ExcessiveOverkill/drive-hardware-dev/KiCad/HV servo drive v1/HV servo drive v1r2.step

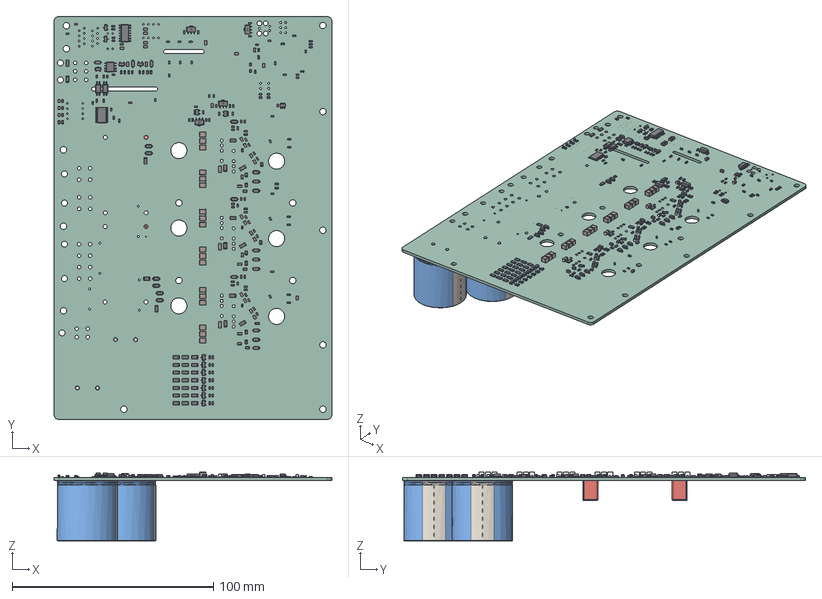
[picture p1: CAD file, 2025-09-05]
KiCad/HV servo drive v1/HV servo drive v1r2.step
138.2 x 200.4 x 34.2 mm
R_1206_3216Metric x 33
D_SOD_123 x 21
R_0603_1608Metric x 56
L_0603_1608Metric x 13
C_0603_1608Metric x 73
C_1210_3225Metric x 18
R_0805_2012Metric x 12
C_0805_2012Metric x 32
SOT_23 x 12
Fuse_1206_3216Metric x 2
C_1206_3216Metric x 3
LED_0603_1608Metric x 4
CQ assembly x 4
SOP_4_44x26mm_P127mm x 2
SOT_23_6
SOIC_14_39x87mm_P127mm
SOT_23_5 x 2
TSSOP_24_44x78mm_P065mm
SOIC_8_39x49mm_P127mm
C_Rect_L75mm_W65mm_P500mm x 2
CP_Radial_D300mm_P1000mm_SnapIn x 2
HV servo drive v1_PCB
