ExcessiveOverkill/drive-hardware-dev/manufacturing/case v3 bottom.stp

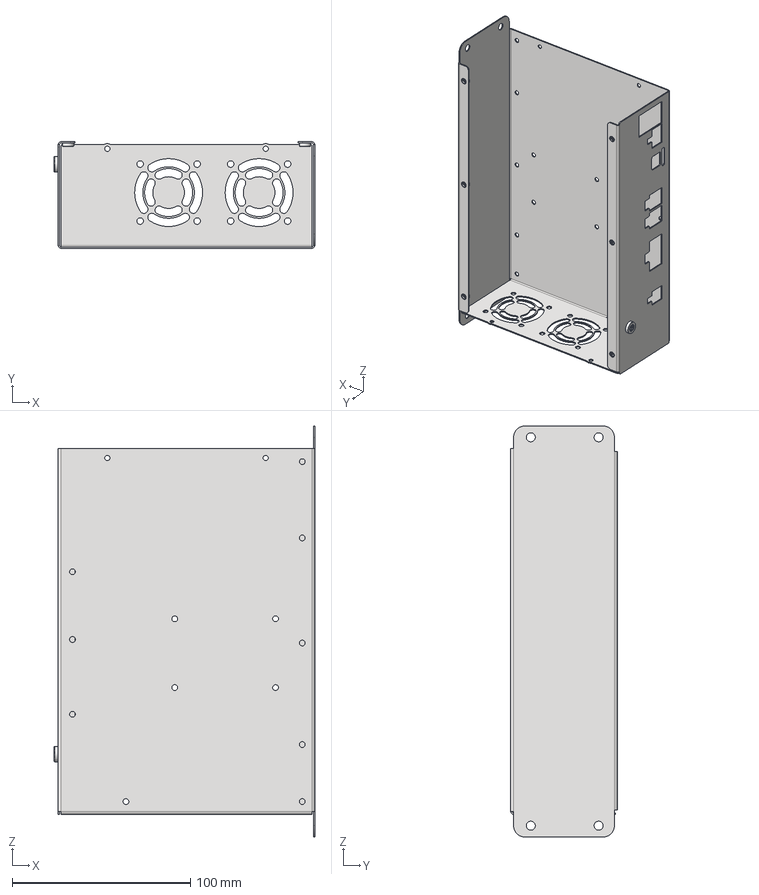
[picture p2: CAD file, 2025-09-05]
manufacturing/case v3 bottom.stp
146.3 x 59.8 x 230.7 mm
case v3_1
95185A110 x 6
95185A340
