ExcessiveOverkill/drive-hardware-dev/KiCad/HV servo drive v1/HV servo drive v1.step

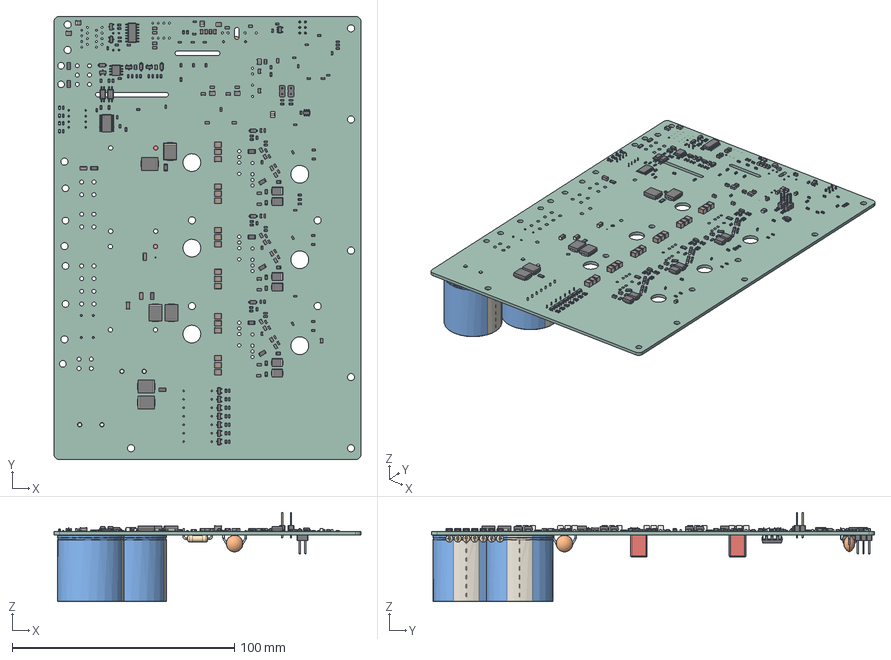
[picture p3: CAD file, 2025-09-05]
KiCad/HV servo drive v1/HV servo drive v1.step
138.2 x 199.5 x 40.2 mm
D_SMB x 6
R_0603_1608Metric x 59
C_0603_1608Metric x 60
C_1210_3225Metric x 18
PinHeader_1x02_P254mm_Vertical x 2
R_0805_2012Metric x 9
D_SOD_123 x 6
C_0805_2012Metric x 42
R_1206_3216Metric x 10
SOT_23 x 12
Fuse_1206_3216Metric x 2
C_1206_3216Metric x 4
L_1008_2520Metric x 8
LED_0603_1608Metric x 4
D_SMC x 6
L_0603_1608Metric x 9
SOP_4_44x26mm_P127mm x 2
SOT_23_5
SOT_23_6
SOIC_14_39x87mm_P127mm
TSSOP_24_44x78mm_P065mm
SOIC_8_39x49mm_P127mm
C_Disc_D75mm_W50mm_P1000mm x 3
R_Axial_DIN0309_L90mm_D32mm_P1270mm_Horizontal x 7
PinHeader_2x03_P254mm_Vertical
C_Rect_L75mm_W65mm_P500mm x 2
CP_Radial_D300mm_P1000mm_SnapIn x 2
DIP-8_W7.62mm
DIP-4_W7.62mm
HV servo drive v1_PCB
