ExcessiveOverkill/drive-hardware-dev/manufacturing/SanAce_9GA_40x20_RBD.stp

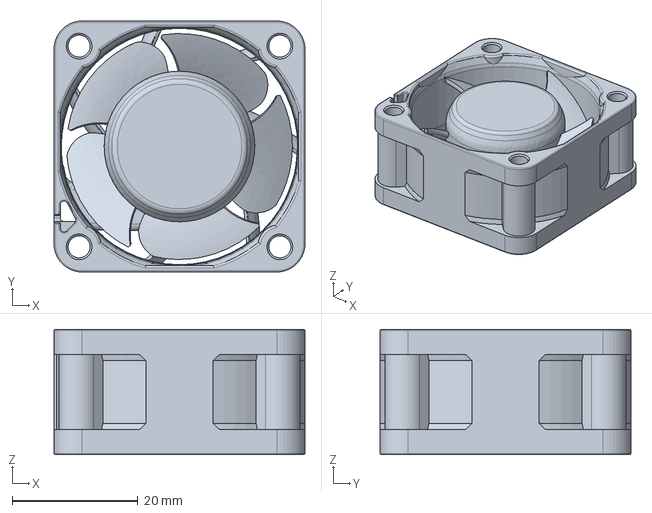
[picture p4: CAD file, 2025-09-05]
manufacturing/SanAce_9GA_40x20_RBD.stp
40.0 x 40.0 x 20.0 mm
