ExcessiveOverkill/drive-hardware-dev/manufacturing/front face.dxf

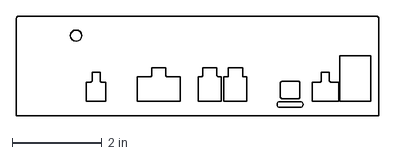
[picture p5: CAD file, 2025-09-05]
manufacturing/front face.dxf
8.08 x 2.23 in
