ExcessiveOverkill/drive-hardware-dev/manufacturing/fet leg bender.stl

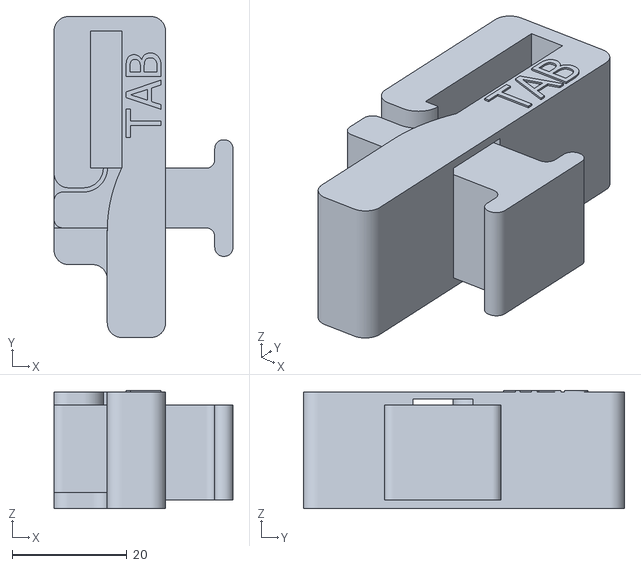
[picture p6: CAD file, 2025-09-05]
manufacturing/fet leg bender.stl
31.2 x 55.9 x 20.6
