ExcessiveOverkill/drive-hardware-dev/manufacturing/case v3 top.stp

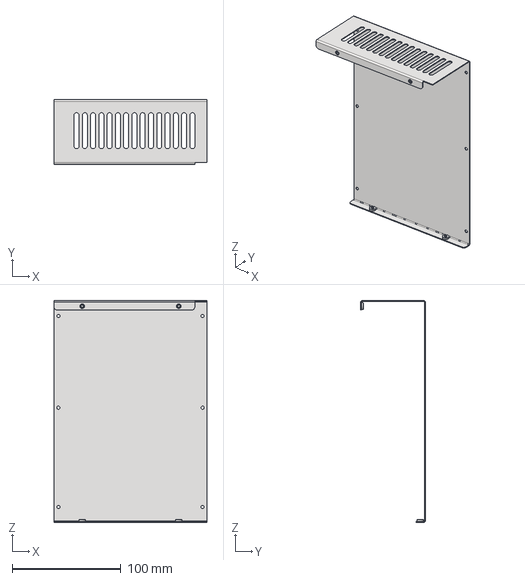
[picture p7: CAD file, 2025-09-05]
manufacturing/case v3 top.stp
140.8 x 59.8 x 204.5 mm
case v3 cover
95185A110 x 4
