ExcessiveOverkill/drive-hardware-dev/manufacturing/case v2 bottom.stp

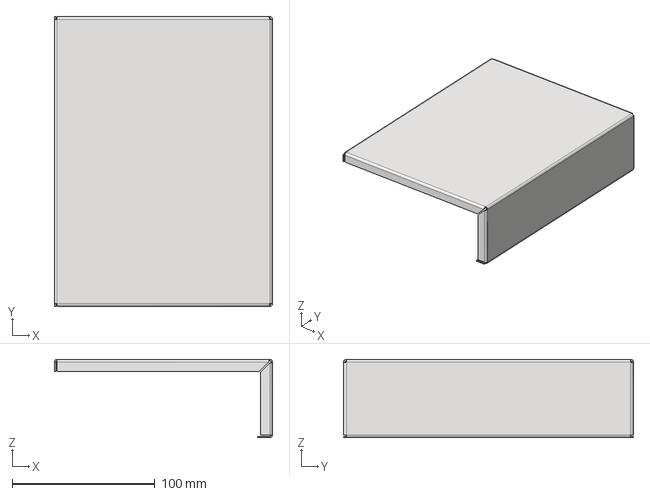
[picture p8: CAD file, 2025-09-05, an earlier design]
manufacturing/case v2 bottom.stp
152.9 x 203.2 x 54.9 mm
