ExcessiveOverkill/drive-hardware-dev/(list of files, cad)

Other CAD files:
manufacturing/case top.dwg
manufacturing/case bottom.dwg
manufacturing/OldVersions/case bottom.0001.dwg
manufacturing/OldVersions/case top.0002.dwg
manufacturing/OldVersions/case top.0001.dwg
manufacturing/HV servo drive v1 PCB.ipt
manufacturing/OldVersions/Solid1.0001.ipt
manufacturing/OldVersions/Solid2.0001.ipt
manufacturing/OldVersions/Solid2.0002.ipt
manufacturing/OldVersions/case v2.0002.ipt
manufacturing/OldVersions/case v3 cover.0001.ipt
manufacturing/OldVersions/case v3 cover.0002.ipt
manufacturing/OldVersions/case v3 cover.0003.ipt
manufacturing/OldVersions/case v3.0012.iam
manufacturing/OldVersions/case v3.0026.ipt
manufacturing/OldVersions/fet leg bender.0001.ipt
manufacturing/OldVersions/fet leg bender.0002.ipt
manufacturing/OldVersions/heatsink v2.0001.ipt
manufacturing/OldVersions/heatsink v2.0002.ipt
manufacturing/OldVersions/heatsink v2.0003.ipt
manufacturing/OldVersions/heatsink v2.0004.ipt
manufacturing/Solid1.ipt
manufacturing/Solid2.ipt
manufacturing/case v2.ipt
manufacturing/case v3 cover.ipt
manufacturing/case v3.iam
manufacturing/case v3.ipt
manufacturing/fet leg bender.ipt
manufacturing/heatsink v2.ipt
manufacturing/simple step/95185A110_Zinc-Plated Steel Press-Fit Nut for Sheet Metal/95185A110_Zinc-Plated Steel Press-Fit Nut for Sheet Metal.ipt
manufacturing/simple step/95185A340_Zinc-Plated Steel Press-Fit Nut for Sheet Metal/95185A340_Zinc-Plated Steel Press-Fit Nut for Sheet Metal.ipt
manufacturing/simple step/CP_Radial_D30.0mm_P10.00mm_SnapIn.iam
manufacturing/simple step/CP_Radial_D300mm_P1000mm_SnapIn.ipt
manufacturing/simple step/C_0603_1608Metric.iam
manufacturing/simple step/C_0603_1608Metric.ipt
manufacturing/simple step/C_0805_2012Metric.iam
manufacturing/simple step/C_0805_2012Metric.ipt
manufacturing/simple step/C_1206_3216Metric.iam
manufacturing/simple step/C_1206_3216Metric.ipt
manufacturing/simple step/C_1210_3225Metric.iam
manufacturing/simple step/C_1210_3225Metric.ipt
manufacturing/simple step/C_Disc_D7.5mm_W5.0mm_P10.00mm.iam
manufacturing/simple step/C_Disc_D75mm_W50mm_P1000mm.ipt
manufacturing/simple step/C_Rect_L7.5mm_W6.5mm_P5.00mm.iam
manufacturing/simple step/C_Rect_L75mm_W65mm_P500mm.ipt
manufacturing/simple step/DIP-4_W7.62mm.iam
manufacturing/simple step/DIP-4_W7.62mm.ipt
manufacturing/simple step/DIP-8_W7.62mm.iam
manufacturing/simple step/DIP-8_W7.62mm.ipt
manufacturing/simple step/D_SMB.iam
manufacturing/simple step/D_SMB.ipt
manufacturing/simple step/D_SMC.iam
manufacturing/simple step/D_SMC.ipt
manufacturing/simple step/D_SOD-123.iam
manufacturing/simple step/D_SOD_123.ipt
manufacturing/simple step/Fuse_1206_3216Metric.iam
manufacturing/simple step/Fuse_1206_3216Metric.ipt
manufacturing/simple step/HV servo drive v1.iam
manufacturing/simple step/HV servo drive v1_PCB.ipt
manufacturing/simple step/HV servo drive v1r2/CP_Radial_D30.0mm_P10.00mm_SnapIn.iam
manufacturing/simple step/HV servo drive v1r2/CP_Radial_D300mm_P1000mm_SnapIn.ipt
manufacturing/simple step/HV servo drive v1r2/CQ assembly.ipt
manufacturing/simple step/HV servo drive v1r2/C_0603_1608Metric.iam
manufacturing/simple step/HV servo drive v1r2/C_0603_1608Metric.ipt
manufacturing/simple step/HV servo drive v1r2/C_0805_2012Metric.iam
manufacturing/simple step/HV servo drive v1r2/C_0805_2012Metric.ipt
manufacturing/simple step/HV servo drive v1r2/C_1206_3216Metric.iam
manufacturing/simple step/HV servo drive v1r2/C_1206_3216Metric.ipt
manufacturing/simple step/HV servo drive v1r2/C_1210_3225Metric.iam
manufacturing/simple step/HV servo drive v1r2/C_1210_3225Metric.ipt
manufacturing/simple step/HV servo drive v1r2/C_Rect_L7.5mm_W6.5mm_P5.00mm.iam
manufacturing/simple step/HV servo drive v1r2/C_Rect_L75mm_W65mm_P500mm.ipt
manufacturing/simple step/HV servo drive v1r2/D_SOD-123.iam
manufacturing/simple step/HV servo drive v1r2/D_SOD_123.ipt
manufacturing/simple step/HV servo drive v1r2/Fuse_1206_3216Metric.iam
manufacturing/simple step/HV servo drive v1r2/Fuse_1206_3216Metric.ipt
manufacturing/simple step/HV servo drive v1r2/HV servo drive v1_PCB.ipt
manufacturing/simple step/HV servo drive v1r2/HV servo drive v1r2.iam
manufacturing/simple step/HV servo drive v1r2/LED_0603_1608Metric.iam
manufacturing/simple step/HV servo drive v1r2/LED_0603_1608Metric.ipt
manufacturing/simple step/HV servo drive v1r2/L_0603_1608Metric.iam
manufacturing/simple step/HV servo drive v1r2/L_0603_1608Metric.ipt
manufacturing/simple step/HV servo drive v1r2/OldVersions/HV servo drive v1_PCB.0001.ipt
manufacturing/simple step/HV servo drive v1r2/OldVersions/HV servo drive v1_PCB.0002.ipt
manufacturing/simple step/HV servo drive v1r2/OldVersions/HV servo drive v1_PCB.0003.ipt
manufacturing/simple step/HV servo drive v1r2/OldVersions/HV servo drive v1r2.0001.iam
manufacturing/simple step/HV servo drive v1r2/R_0603_1608Metric.iam
manufacturing/simple step/HV servo drive v1r2/R_0603_1608Metric.ipt
manufacturing/simple step/HV servo drive v1r2/R_0805_2012Metric.iam
manufacturing/simple step/HV servo drive v1r2/R_0805_2012Metric.ipt
manufacturing/simple step/HV servo drive v1r2/R_1206_3216Metric.iam
manufacturing/simple step/HV servo drive v1r2/R_1206_3216Metric.ipt
manufacturing/simple step/HV servo drive v1r2/SOIC-14_3.9x8.7mm_P1.27mm.iam
manufacturing/simple step/HV servo drive v1r2/SOIC-8_3.9x4.9mm_P1.27mm.iam
manufacturing/simple step/HV servo drive v1r2/SOIC_14_39x87mm_P127mm.ipt
manufacturing/simple step/HV servo drive v1r2/SOIC_8_39x49mm_P127mm.ipt
manufacturing/simple step/HV servo drive v1r2/SOP-4_4.4x2.6mm_P1.27mm.iam
manufacturing/simple step/HV servo drive v1r2/SOP_4_44x26mm_P127mm.ipt
manufacturing/simple step/HV servo drive v1r2/SOT-23-5.iam
manufacturing/simple step/HV servo drive v1r2/SOT-23-6.iam
manufacturing/simple step/HV servo drive v1r2/SOT-23.iam
manufacturing/simple step/HV servo drive v1r2/SOT-89-3.iam
manufacturing/simple step/HV servo drive v1r2/SOT_23.ipt
manufacturing/simple step/HV servo drive v1r2/SOT_23_5.ipt
manufacturing/simple step/HV servo drive v1r2/SOT_23_6.ipt
manufacturing/simple step/HV servo drive v1r2/TSSOP-24_4.4x7.8mm_P0.65mm.iam
manufacturing/simple step/HV servo drive v1r2/TSSOP_24_44x78mm_P065mm.ipt
manufacturing/simple step/LED_0603_1608Metric.iam
manufacturing/simple step/LED_0603_1608Metric.ipt
manufacturing/simple step/L_0603_1608Metric.iam
manufacturing/simple step/L_0603_1608Metric.ipt
manufacturing/simple step/L_1008_2520Metric.iam
manufacturing/simple step/L_1008_2520Metric.ipt
manufacturing/simple step/OldVersions/HV servo drive v1_PCB.0001.ipt
manufacturing/simple step/PinHeader_1x02_P2.54mm_Vertical.iam
manufacturing/simple step/PinHeader_1x02_P254mm_Vertical.ipt
manufacturing/simple step/PinHeader_2x03_P2.54mm_Vertical.iam
manufacturing/simple step/PinHeader_2x03_P254mm_Vertical.ipt
manufacturing/simple step/R_0603_1608Metric.iam
manufacturing/simple step/R_0603_1608Metric.ipt
manufacturing/simple step/R_0805_2012Metric.iam
manufacturing/simple step/R_0805_2012Metric.ipt
manufacturing/simple step/R_1206_3216Metric.iam
manufacturing/simple step/R_1206_3216Metric.ipt
manufacturing/simple step/R_Axial_DIN0309_L9.0mm_D3.2mm_P12.70mm_Horizontal.iam
manufacturing/simple step/R_Axial_DIN0309_L90mm_D32mm_P1270mm_Horizontal.ipt
manufacturing/simple step/SOIC-14_3.9x8.7mm_P1.27mm.iam
manufacturing/simple step/SOIC-8_3.9x4.9mm_P1.27mm.iam
manufacturing/simple step/SOIC_14_39x87mm_P127mm.ipt
manufacturing/simple step/SOIC_8_39x49mm_P127mm.ipt
manufacturing/simple step/SOP-4_4.4x2.6mm_P1.27mm.iam
manufacturing/simple step/SOP_4_44x26mm_P127mm.ipt
manufacturing/simple step/SOT-23-5.iam
manufacturing/simple step/SOT-23-6.iam
manufacturing/simple step/SOT-23.iam
manufacturing/simple step/SOT_23.ipt
manufacturing/simple step/SOT_23_5.ipt
manufacturing/simple step/SOT_23_6.ipt
manufacturing/simple step/SanAce_9GA_40x20_RBD/SanAce_9GA_40x20_RBD.ipt
manufacturing/simple step/TSSOP-24_4.4x7.8mm_P0.65mm.iam
manufacturing/simple step/TSSOP_24_44x78mm_P065mm.ipt
