ExcessiveOverkill/drive-hardware-dev/(threads)

Thread 11 (2024-03-10):

ADC power limiting for safety

ExcessiveOverkill, 2024-03-10:
Limit power supplied to the ADCs from both sides. In the event of a power supply failure, the ADCs may overheat and cause damage to the isolation layer which is VERY bad.

This is not a critical issue as there is already separate isolation for the main communication.

Thread 12 (2024-03-10):

shorted trace in gate drive circuit

ExcessiveOverkill, 2024-03-10:
remove bridged trace

Closed 2025-09-05.

Thread 13 (2024-03-10):

HV HF filter caps

ExcessiveOverkill, 2024-03-10:
Add high frequency ceramic caps near each fet bridge for DC bus filtering and phase overshoot filtering.

Closed 2025-09-05.

Thread 16 (2024-03-10):

mosfet bridge tuning

ExcessiveOverkill, 2024-03-10:
optimize gate drive resistance and filter capacitors to get efficient switching without too much EMI

Closed 2025-09-05.

Thread 17 (2024-03-10):

isolation slots

ExcessiveOverkill, 2024-03-10:
add isolation/clearance slots where needed

Closed 2025-09-05.

Thread 3 (2024-03-10):

MCU STO pin

ExcessiveOverkill, 2024-03-10:
investigate why STO is not active by default. It should require input from the MCU to enable power outputs

Aaron-Levan, 2024-04-23:
How was the output from the MCU configured?
From the 6N137 datasheet, the opto will operate if the enable input is left floating.
It looks like a pulldown on the opto's enable input should keep STO active unless the MCU output is high.

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

ExcessiveOverkill, 2024-04-23:
ah that would do it. the MCU output was unconfigured so it was floating

Closed 2025-09-05.

Thread 4 (2024-03-10):

RJ45 connector wrong pinout

ExcessiveOverkill, 2024-03-10:
fix pinout for rj45 jack, one of the connector's pin order is reversed

Closed 2025-09-05.

Thread 5 (2024-03-10):

gate drive supply reverse polarity protection

ExcessiveOverkill, 2024-03-10:
fit the issue where the low side gate drive supply can be driven negative by the gate drivers if the dc-dc converter is not connected. this can result in not being able to switch off the fets.

Closed 2025-09-05.

Thread 6 (2024-03-10):

dc-dc converter wrong footprint

ExcessiveOverkill, 2024-03-10:
fix the footprint for the +15v gate drive isolated converter

Closed 2025-09-05.

Thread 7 (2024-03-10):

add another heatsink mounting hole

ExcessiveOverkill, 2024-03-10:
add another hole so the board doesn't flex as much

Thread 8 (2024-03-10):

clearance between heatsink and electrolysic bus caps

ExcessiveOverkill, 2024-03-10:
add space between heatsink and dc bus caps

Thread 21 (2025-09-05):

Fix output filter

ExcessiveOverkill, 2025-09-05:
Revise output filter to fix inductor overvoltage, resistor heating, and uneven filtering. See about switching to SMD caps on the output.

Thread 22 (2025-09-05):

rs422 EMI reduction

ExcessiveOverkill, 2025-09-05:
Add filtering to the communication ports to help reduce conducted EMI
