ExcessiveOverkill/drive-hardware-dev/KiCad/HV servo drive v1/HV servo drive v1.kicad_pcb

## KiCad design KiCad/HV servo drive v1/HV servo drive v1.kicad_pcb (2025-09-05)

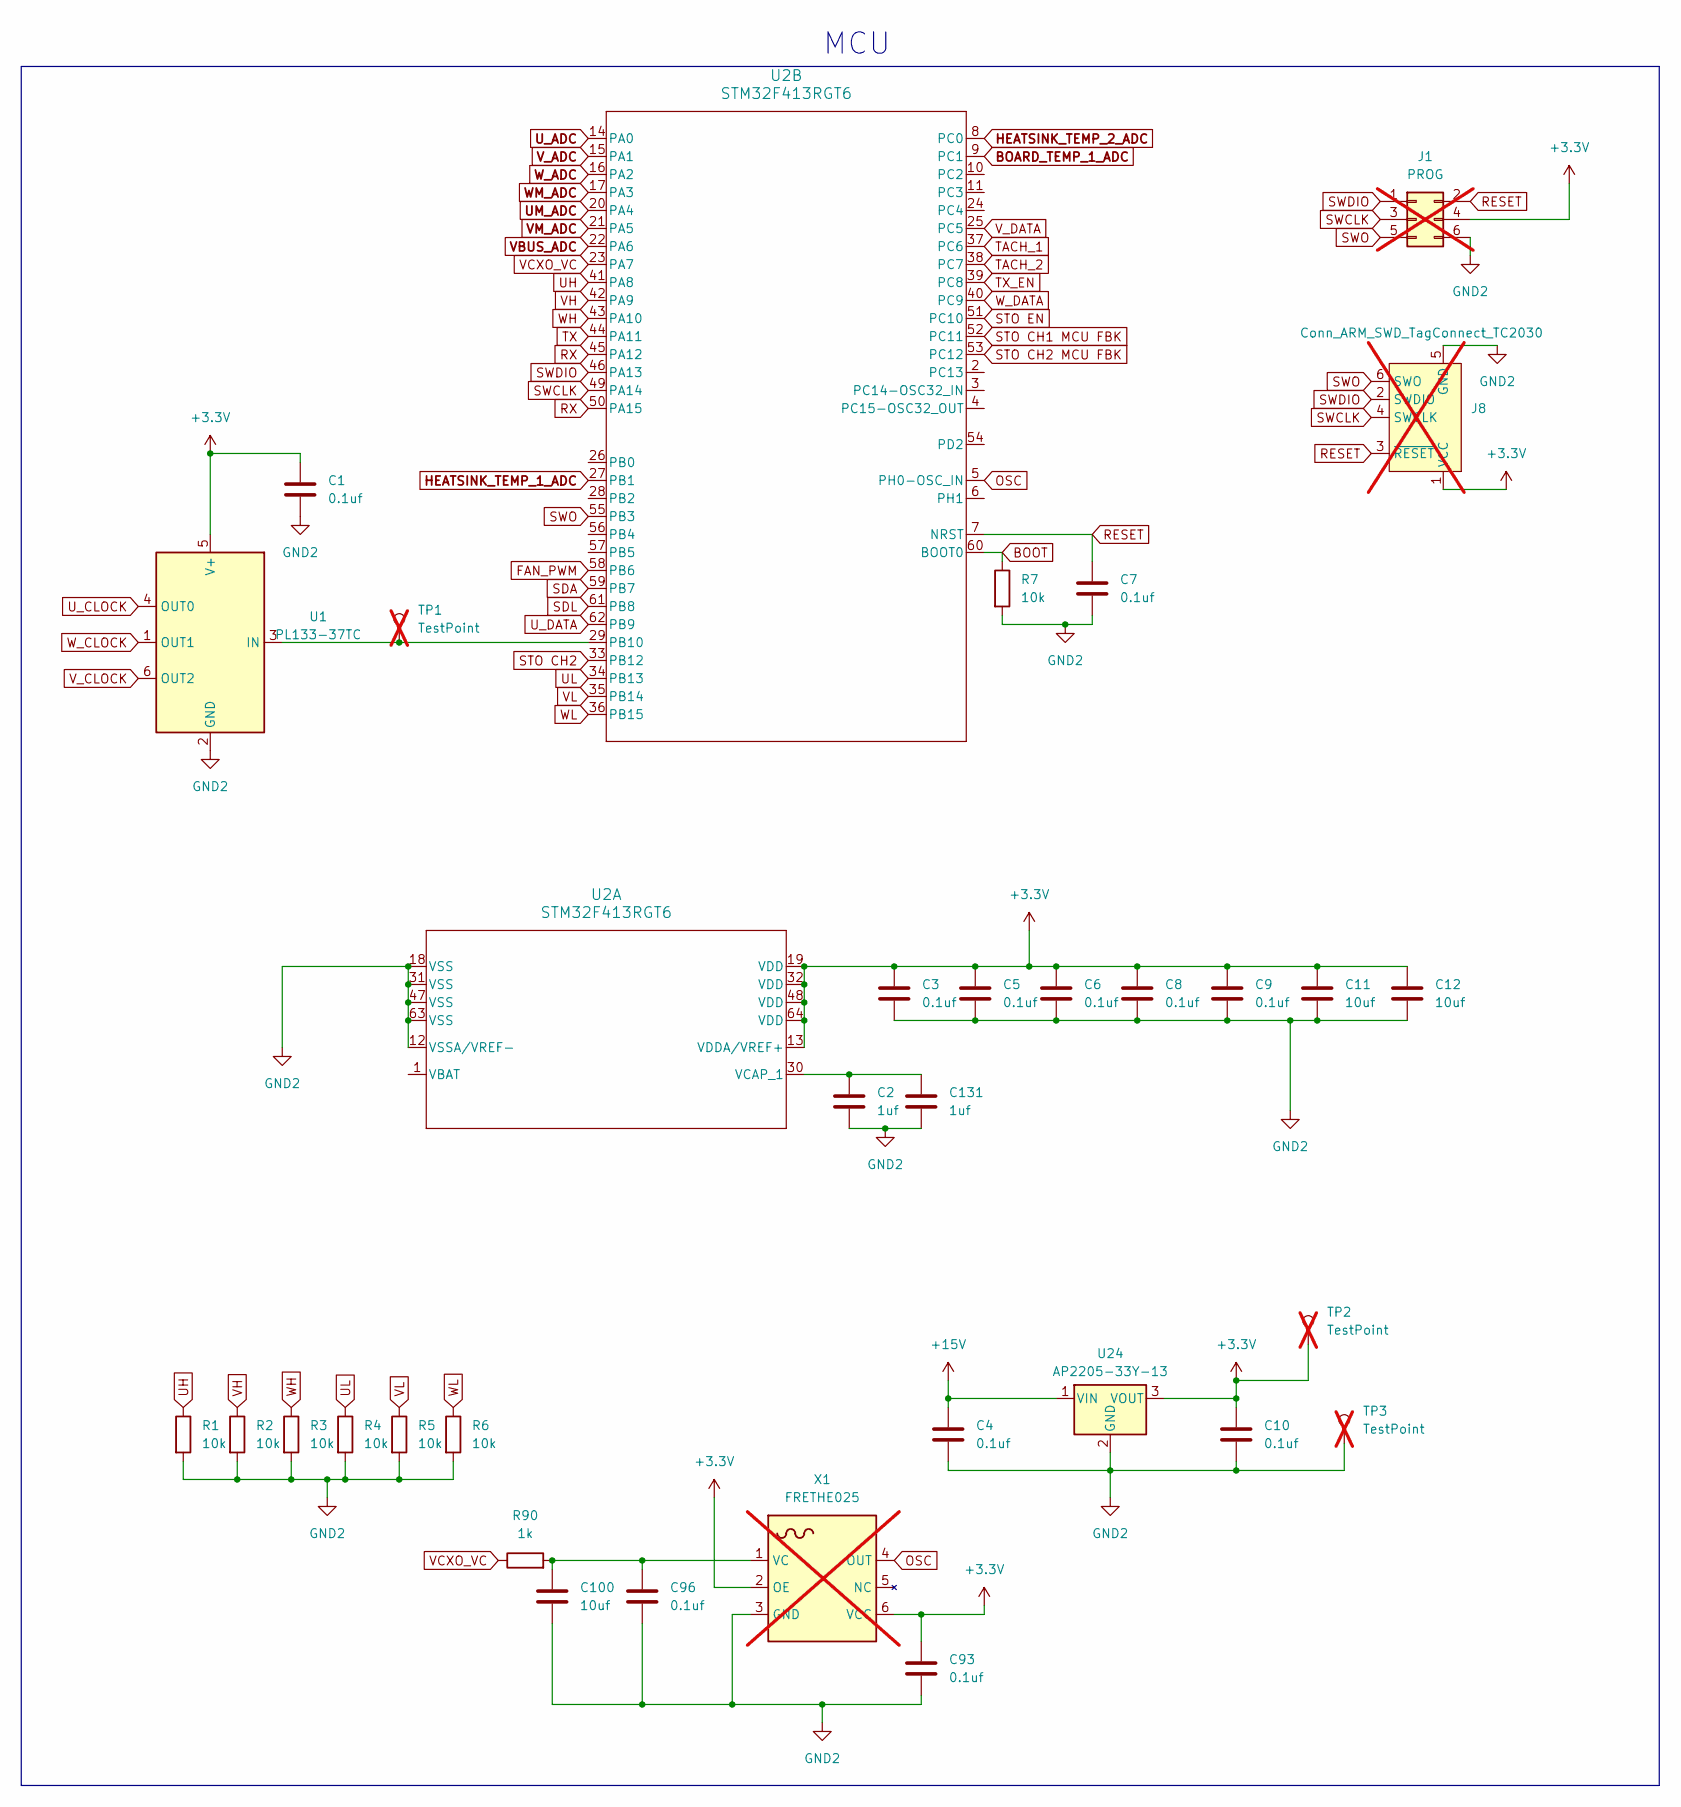
[picture p9: schematic mcu.kicad_sch]

Parts:
C1, C3, C4, C5, C6, C7, C8, C9, C10, C93, C96: 0.1uf; C_0603_1608Metric; Part number CC0603ZRY5V9BB104
C2, C131: 1uf; C_0603_1608Metric; Part number CL10A105KB8NNNC
C11, C12, C100: 10uf; C_0805_2012Metric; Part number GRM21BR61H106KE43L
J1: PROG; PinHeader_2x03_P2.54mm_Vertical; not fitted
J8: Conn_ARM_SWD_TagConnect_TC2030; Tag-Connect_TC2030-IDC-FP_2x03_P1.27mm_Vertical; not fitted
R1, R2, R3, R4, R5, R6, R7: 10k; R_0603_1608Metric; Part number RC0603FR-0710KL
R90: 1k; R_0603_1608Metric; Part number RC0603FR-071KL
TP1, TP2, TP3: TestPoint; TestPoint_Pad_3.1x1.6mm; not fitted
U1: PL133-37TC; SOT-23-6; Part number PL133-37TC
U2: STM32F413RGT6; LQFP64-10x10mm; Part number STM32F413RGT6
U24: AP2205-33Y-13; SOT-89-3; Part number AP2205-33Y-13
X1: FRETHE025; FR_3-3V; Part number FRETHE025; not fitted

Connections:
+3.3V: C1.1, C3.1, C5.1, C6.1, C8.1, C9.1, C10.1, C11.1, C12.1, C93.1, J1.4, J8.1 (VCC), TP2.1, U1.5 (V+), U2.13 (VDDA/VREF+), U2.19 (VDD), U2.32 (VDD), U2.48 (VDD), U2.64 (VDD), U24.3 (VOUT), X1.2 (OE), X1.6 (VCC); also elsewhere on the board
+15V: C4.1, U24.1 (VIN); also elsewhere on the board
BOARD_TEMP_1_ADC: U2.9 (PC1); also elsewhere on the board
BOOT: R7.1, U2.60 (BOOT0)
FAN_PWM: U2.58 (PB6); also elsewhere on the board
GND2: C1.2, C2.2, C3.2, C4.2, C5.2, C6.2, C7.2, C8.2, C9.2, C10.2, C11.2, C12.2, C93.2, C96.2, C100.2, C131.2, J1.6, J8.5 (GND), R1.2, R2.2, R3.2, R4.2, R5.2, R6.2, R7.2, TP3.1, U1.2 (GND), U2.12 (VSSA/VREF-), U2.18 (VSS), U2.31 (VSS), U2.47 (VSS), U2.63 (VSS), U24.2 (GND), X1.3 (GND); also elsewhere on the board
HEATSINK_TEMP_1_ADC: U2.27 (PB1); also elsewhere on the board
HEATSINK_TEMP_2_ADC: U2.8 (PC0); also elsewhere on the board
unnamed: TP1.1, U1.3 (IN), U2.29 (PB10)
unnamed: C2.1, C131.1, U2.30 (VCAP_1)
unnamed: C96.1, C100.1, R90.2, X1.1 (VC)
OSC: U2.5 (PH0-OSC_IN), X1.4 (OUT)
RESET: C7.1, J1.2, J8.3 (~RESET), U2.7 (NRST)
RX: U2.45 (PA12), U2.50 (PA15); also elsewhere on the board
SDA: U2.59 (PB7); also elsewhere on the board
SDL: U2.61 (PB8); also elsewhere on the board
STO CH1 MCU FBK: U2.52 (PC11); also elsewhere on the board
STO CH2: U2.33 (PB12); also elsewhere on the board
STO CH2 MCU FBK: U2.53 (PC12); also elsewhere on the board
STO EN: U2.51 (PC10); also elsewhere on the board
SWCLK: J1.3, J8.4 (SWCLK), U2.49 (PA14)
SWDIO: J1.1, J8.2 (SWDIO), U2.46 (PA13)
SWO: J1.5, J8.6 (SWO), U2.55 (PB3)
TACH_1: U2.37 (PC6); also elsewhere on the board
TACH_2: U2.38 (PC7); also elsewhere on the board
TX: U2.44 (PA11); also elsewhere on the board
TX_EN: U2.39 (PC8); also elsewhere on the board
UH: R1.1, U2.41 (PA8); also elsewhere on the board
UL: R4.1, U2.34 (PB13); also elsewhere on the board
UM_ADC: U2.20 (PA4); also elsewhere on the board
U_ADC: U2.14 (PA0); also elsewhere on the board
U_CLOCK: U1.4 (OUT0); also elsewhere on the board
U_DATA: U2.62 (PB9); also elsewhere on the board
VBUS_ADC: U2.22 (PA6); also elsewhere on the board
VCXO_VC: R90.1, U2.23 (PA7)
VH: R2.1, U2.42 (PA9); also elsewhere on the board
VL: R5.1, U2.35 (PB14); also elsewhere on the board
VM_ADC: U2.21 (PA5); also elsewhere on the board
V_ADC: U2.15 (PA1); also elsewhere on the board
V_CLOCK: U1.6 (OUT2); also elsewhere on the board
V_DATA: U2.25 (PC5); also elsewhere on the board
WH: R3.1, U2.43 (PA10); also elsewhere on the board
WL: R6.1, U2.36 (PB15); also elsewhere on the board
WM_ADC: U2.17 (PA3); also elsewhere on the board
W_ADC: U2.16 (PA2); also elsewhere on the board
W_CLOCK: U1.1 (OUT1); also elsewhere on the board
W_DATA: U2.40 (PC9); also elsewhere on the board

Notes on the sheet:
MCU

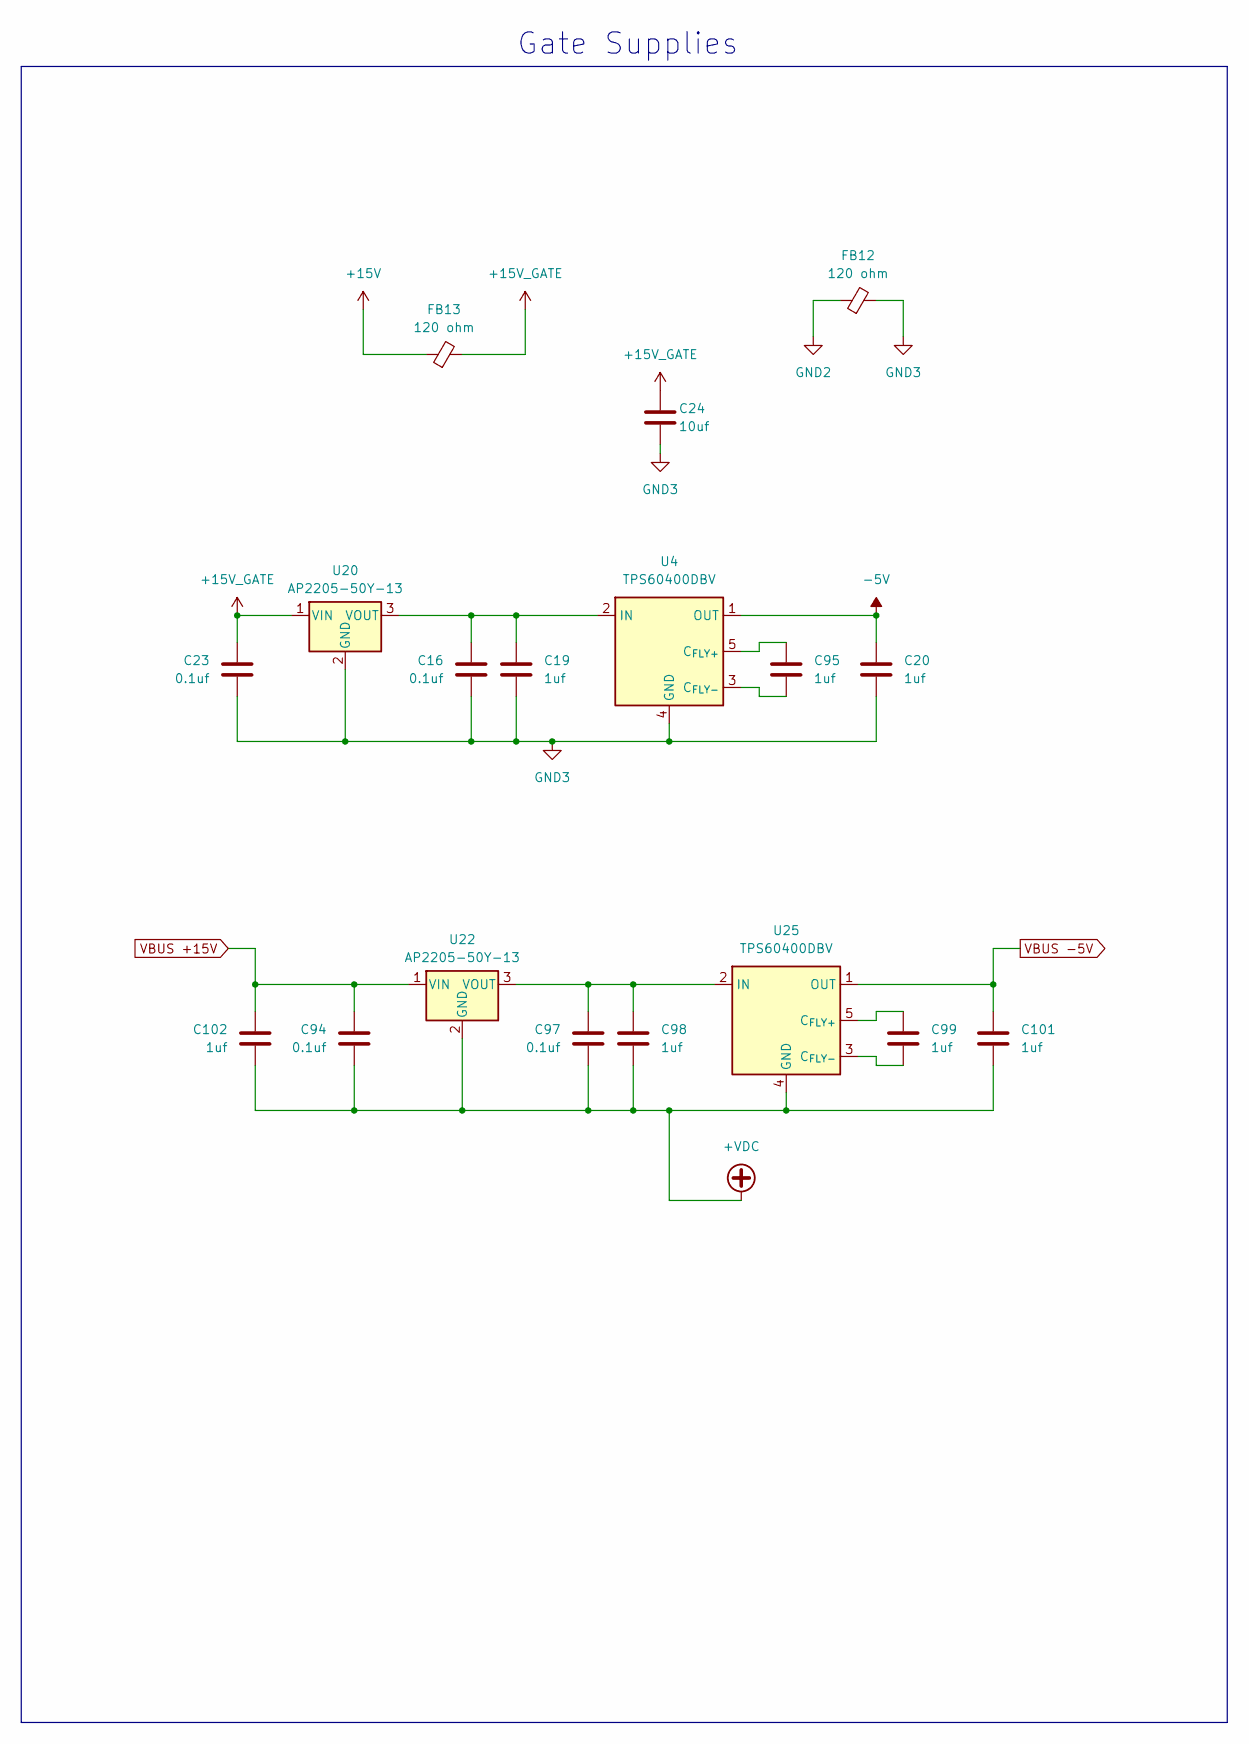
[picture p10: schematic gate supplies.kicad_sch]

Parts:
C16, C23, C94, C97: 0.1uf; C_0603_1608Metric; Part number CC0603ZRY5V9BB104
C19, C20, C95, C98, C99, C101, C102: 1uf; C_0603_1608Metric; Part number CL10A105KB8NNNC
C24: 10uf; C_0805_2012Metric; Part number GRM21BR61H106KE43L
FB12, FB13: 120 ohm; L_0603_1608Metric; Part number LI0603G121R-10
U4, U25: TPS60400DBV; SOT-23-5; Part number TPS60400DBV
U20, U22: AP2205-50Y-13; SOT-89-3; Part number AP2205-50Y-13

Connections:
+15V: FB13.1; also elsewhere on the board
+15V_GATE: C23.1, C24.1, FB13.2, U20.1 (VIN); also elsewhere on the board
-5V: C20.1, U4.1 (OUT); also elsewhere on the board
DCBUS+: C94.2, C97.2, C98.2, C101.2, C102.2, U22.2 (GND), U25.4 (GND); also elsewhere on the board
GND2: FB12.1; also elsewhere on the board
GND3: C16.2, C19.2, C20.2, C23.2, C24.2, FB12.2, U4.4 (GND), U20.2 (GND); also elsewhere on the board
unnamed: C95.1, U4.5 (C_{FLY+})
unnamed: C95.2, U4.3 (C_{FLY-})
unnamed: C16.1, C19.1, U4.2 (IN), U20.3 (VOUT)
unnamed: C97.1, C98.1, U22.3 (VOUT), U25.2 (IN)
unnamed: C99.1, U25.5 (C_{FLY+})
unnamed: C99.2, U25.3 (C_{FLY-})
VBUS +15V: C94.1, C102.1, U22.1 (VIN); also elsewhere on the board
VBUS -5V: C101.1, U25.1 (OUT); also elsewhere on the board

Notes on the sheet:
Gate Supplies

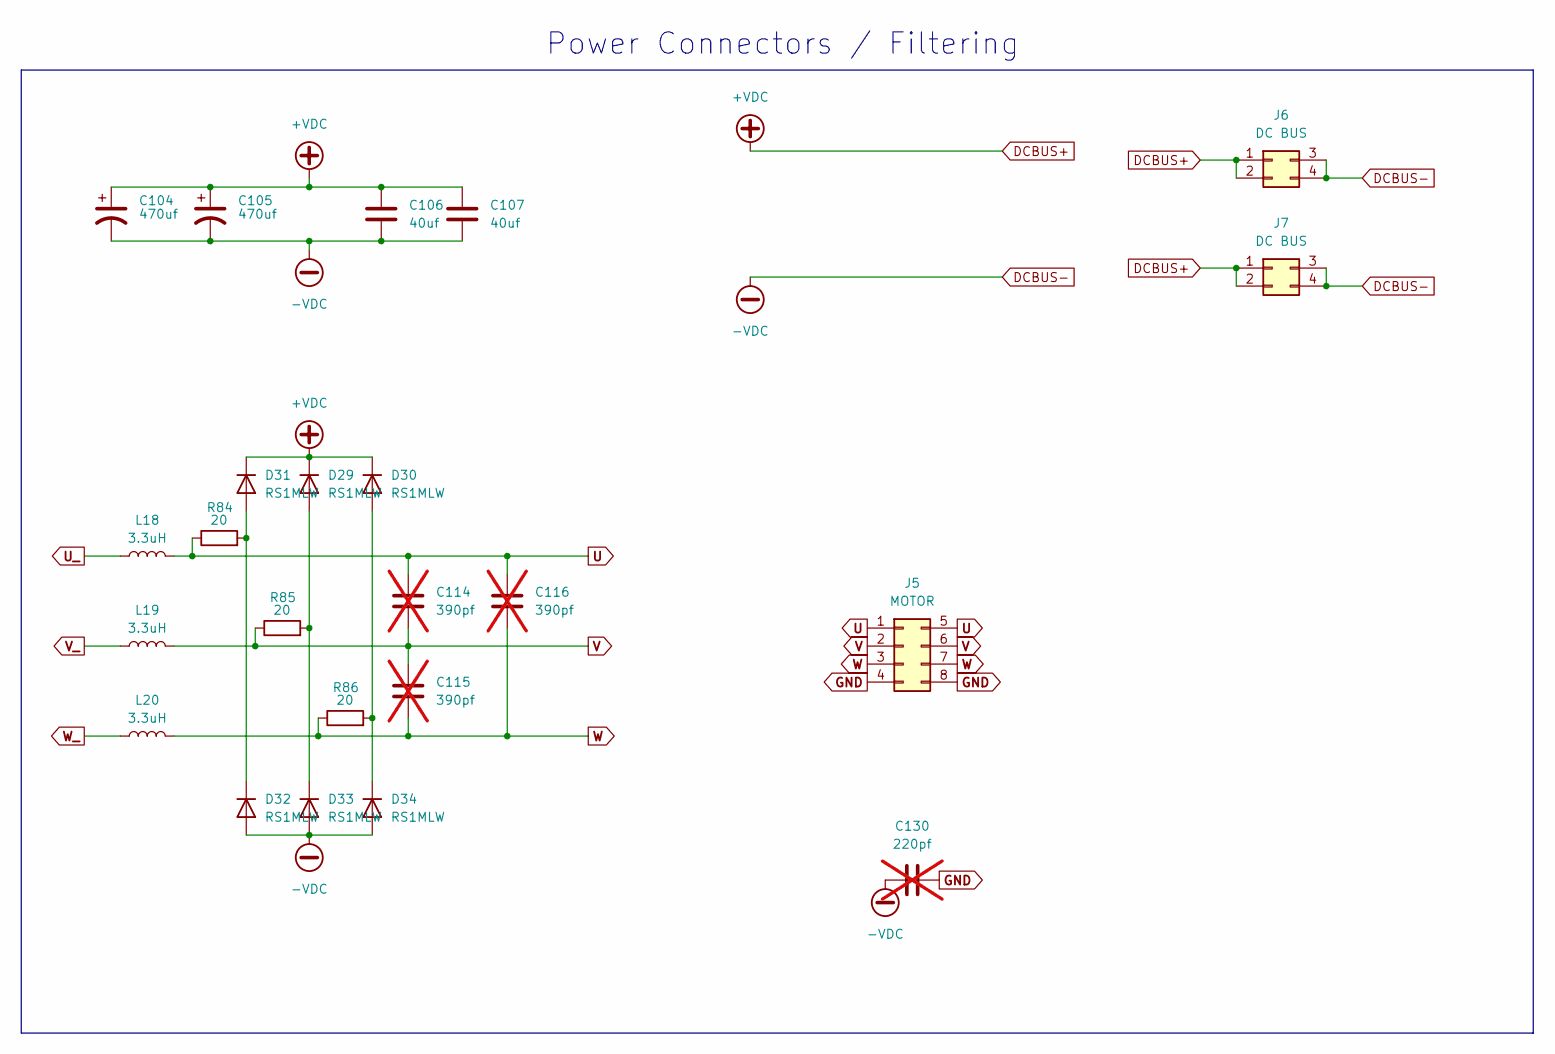
[picture p11: schematic power connectors.kicad_sch]

Parts:
C104, C105: 470uf; CP_Radial_D30.0mm_P10.00mm_SnapIn; Part number ESMQ451VSN471MR45S
C106, C107: 40uf; BUS CAP1; Part number C4AQCBW5400A3LJ
C114, C115, C116: 390pf; B326712L-SMD; Part number CC45SL3AD391JYVNA; not fitted
C130: 220pf; C_Disc_D7.5mm_W5.0mm_P10.00mm; Part number DE1B3RA221KN4AP01F; not fitted
D29, D30, D31, D32, D33, D34: RS1MLW; D_SOD-123W; Part number RS1MLW
J5: MOTOR; Molex_Mega-Fit_76825-0008_2x04_P5.70mm_Horizontal; Part number 0768250008
J6, J7: DC BUS; Molex_Mega-Fit_76825-0004_2x02_P5.70mm_Horizontal; Part number 0768250004
L18, L19, L20: 3.3uH; L_Vishay_IHLP-6767; Part number IHLP6767GZER3R3M01
R84, R85, R86: 20; R_1210_3225Metric; Part number CRCW121020R0JNEAHP

Connections:
DCBUS+: C104.1, C105.1, C106.1, C107.1, D29.1 (K), D30.1 (K), D31.1 (K), J6.1, J6.2, J7.1, J7.2; also elsewhere on the board
DCBUS-: C104.2, C105.2, C106.2, C107.2, C130.2, D32.2 (A), D33.2 (A), D34.2 (A), J6.3, J6.4, J7.3, J7.4; also elsewhere on the board
GND: C130.1, J5.4, J5.8; also elsewhere on the board
unnamed: D29.2 (A), D33.1 (K), R85.2
unnamed: D30.2 (A), D34.1 (K), R86.2
unnamed: D31.2 (A), D32.1 (K), R84.2
U: C114.2, C116.1, J5.1, J5.5, L18.2, R84.1; also elsewhere on the board
U_: L18.1; also elsewhere on the board
V: C114.1, C115.2, J5.2, J5.6, L19.2, R85.1; also elsewhere on the board
V_: L19.1; also elsewhere on the board
W: C115.1, C116.2, J5.3, J5.7, L20.2, R86.1; also elsewhere on the board
W_: L20.1; also elsewhere on the board

Notes on the sheet:
Power Connectors / Filtering

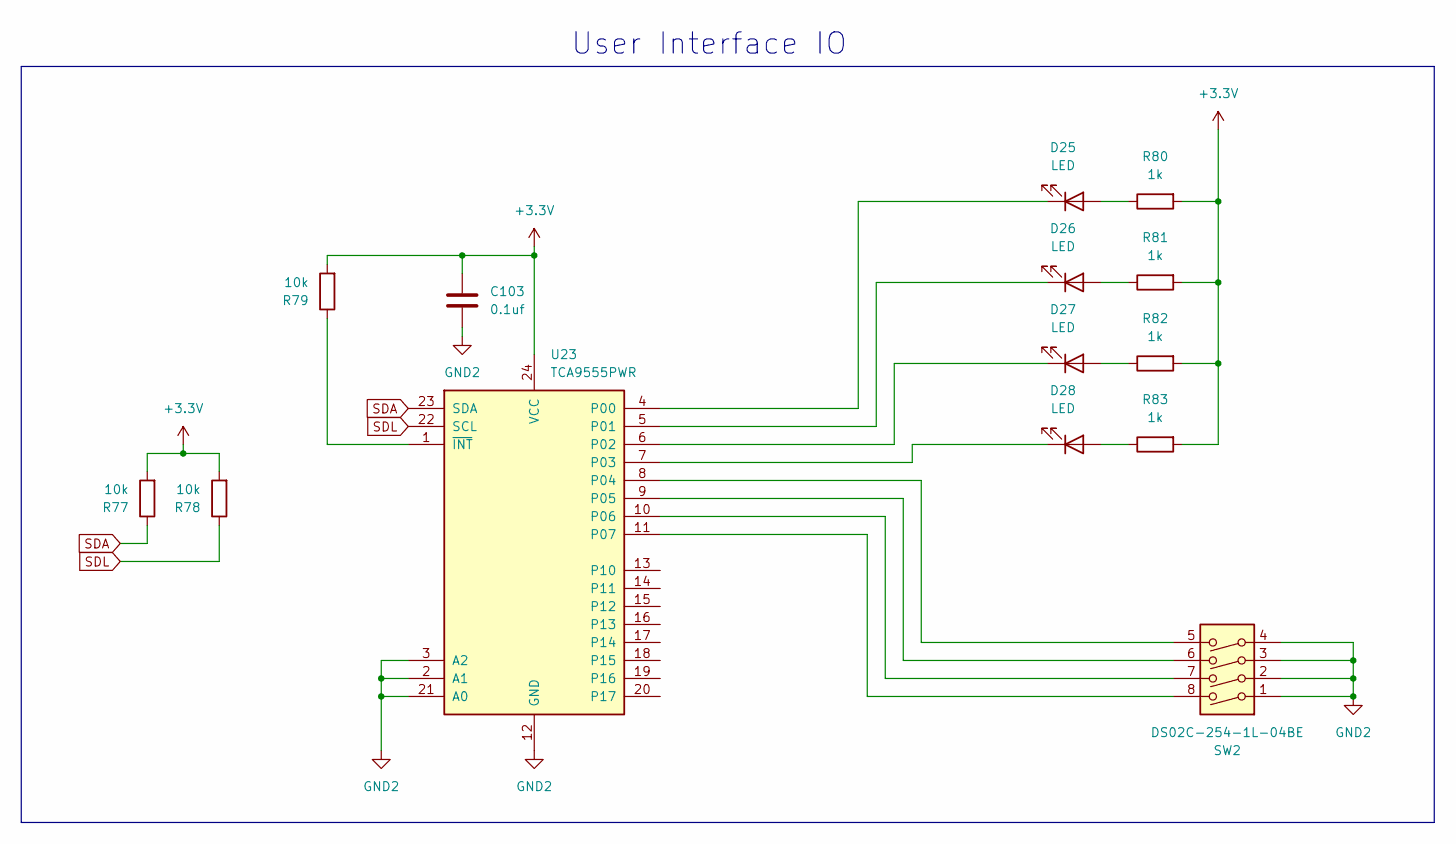
[picture p12: schematic user io.kicad_sch]

Parts:
C103: 0.1uf; C_0603_1608Metric; Part number CC0603ZRY5V9BB104
D25, D26, D27, D28: LED; LED_0603_1608Metric; Part number B1931NG--20D001114U1930
R77, R78, R79: 10k; R_0603_1608Metric; Part number RC0603FR-0710KL
R80, R81, R82, R83: 1k; R_0603_1608Metric; Part number RC0603FR-071KL
SW2: DS02C-254-1L-04BE; DIP-8_W7.62mm; Part number DS02C-254-1L-04BE
U23: TCA9555PWR; TSSOP-24_4.4x7.8mm_P0.65mm; Part number TCA9555PWR

Connections:
+3.3V: C103.1, R77.2, R78.2, R79.2, R80.2, R81.2, R82.2, R83.2, U23.24 (VCC); also elsewhere on the board
GND2: C103.2, SW2.1, SW2.2, SW2.3, SW2.4, U23.2 (A1), U23.3 (A2), U23.12 (GND), U23.21 (A0); also elsewhere on the board
unnamed: D25.2 (A), R80.1
unnamed: D25.1 (K), U23.4 (P00)
unnamed: D26.2 (A), R81.1
unnamed: D26.1 (K), U23.5 (P01)
unnamed: D27.2 (A), R82.1
unnamed: D27.1 (K), U23.6 (P02)
unnamed: D28.2 (A), R83.1
unnamed: D28.1 (K), U23.7 (P03)
unnamed: SW2.5, U23.8 (P04)
unnamed: SW2.6, U23.9 (P05)
unnamed: SW2.7, U23.10 (P06)
unnamed: SW2.8, U23.11 (P07)
unnamed: R79.1, U23.1 (~INT)
SDA: R77.1, U23.23 (SDA); also elsewhere on the board
SDL: R78.1, U23.22 (SCL); also elsewhere on the board

Notes on the sheet:
User Interface IO

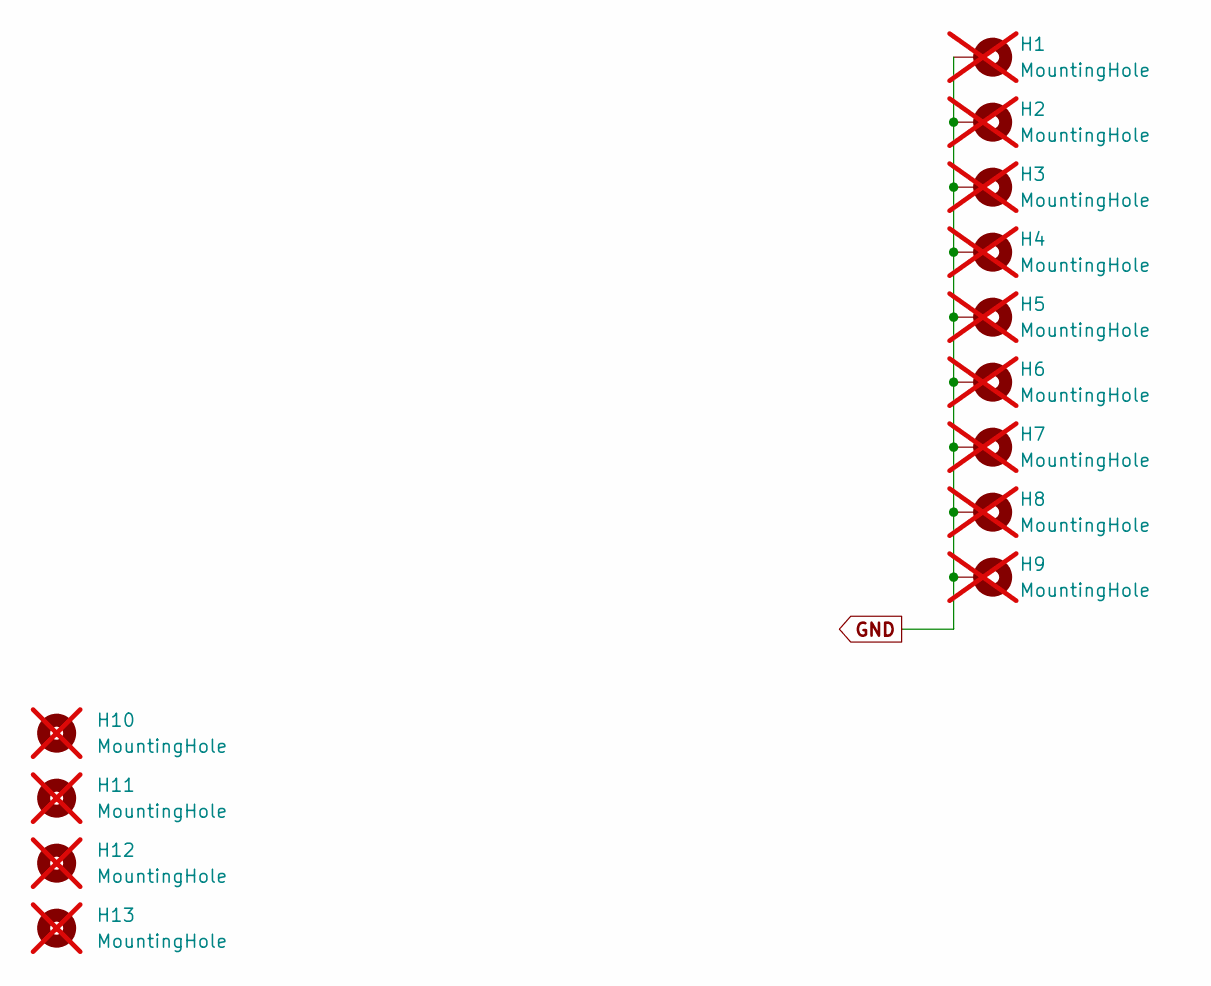
[picture p13: schematic mounting.kicad_sch]

Parts:
H1, H2, H3, H4, H5, H6, H7, H8, H9, H10, H11, H12, H13: MountingHole; MountingHole_3.2mm_M3_Pad_TopBottom_LargeIsolation; not fitted

Connections:
GND: H1.1, H2.1, H3.1, H4.1, H5.1, H6.1, H7.1, H8.1, H9.1; also elsewhere on the board

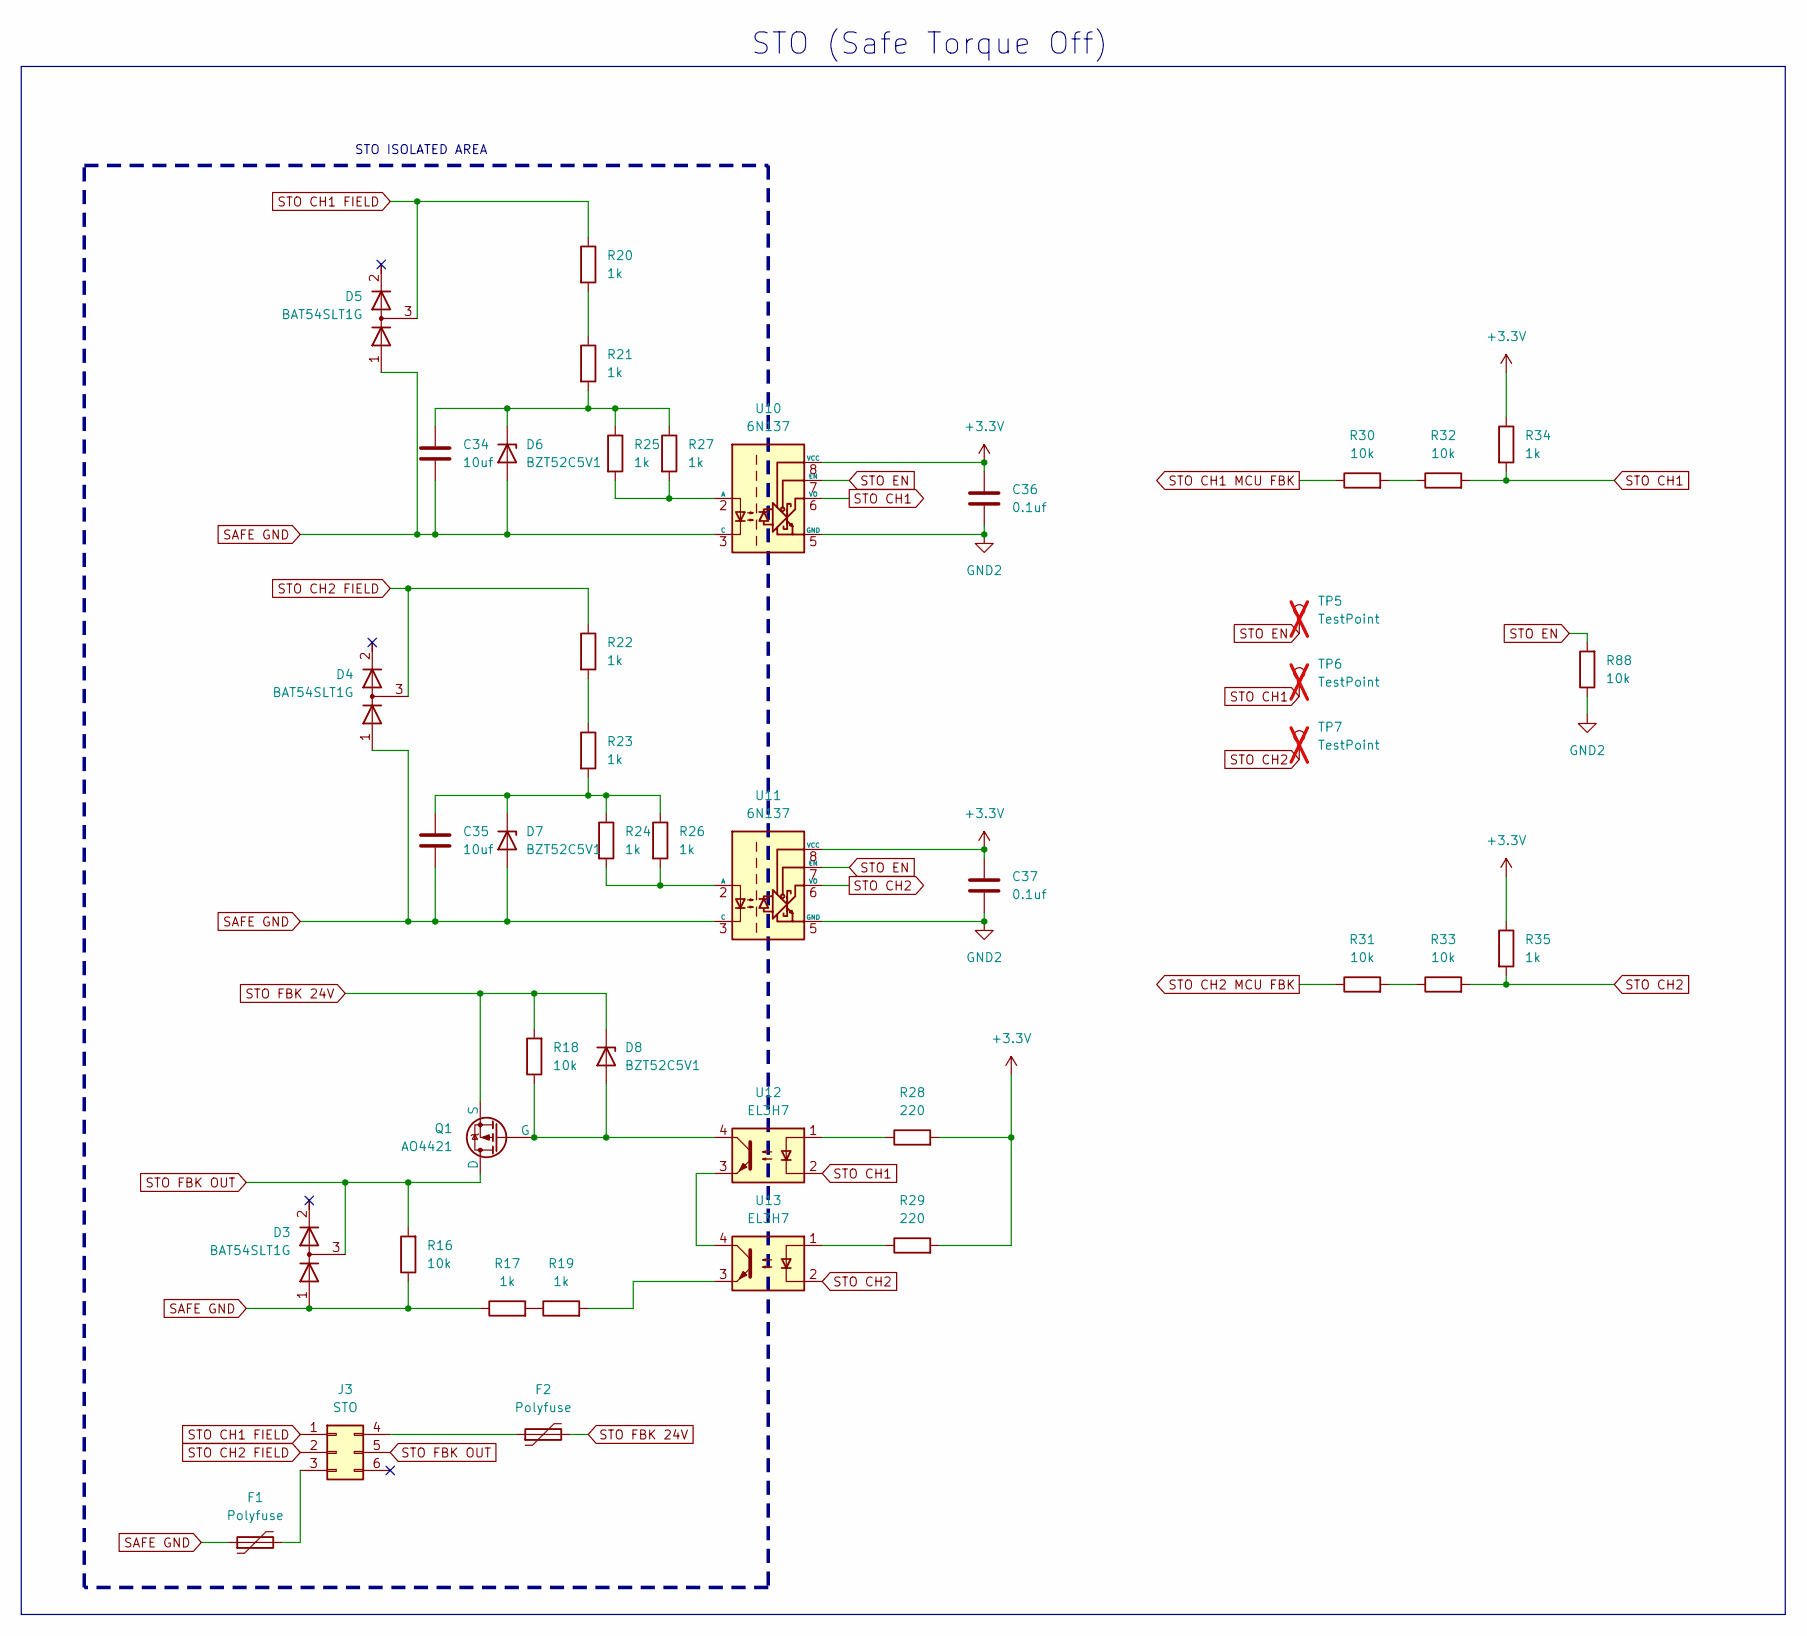
[picture p14: schematic sto.kicad_sch]

Parts:
C34, C35: 10uf; C_0805_2012Metric; Part number GRM21BR61H106KE43L
C36, C37: 0.1uf; C_0603_1608Metric; Part number CC0603ZRY5V9BB104
D3, D4, D5: BAT54SLT1G; SOT-23; Part number BAT54SLT1G
D6, D7, D8: BZT52C5V1; D_SOD-123; Part number BZT52C5V1-TP
F1, F2: Polyfuse; Fuse_1206_3216Metric; Part number PTS120660V005
J3: STO; Molex_Mini-Fit_Jr_0455580003_2x03_P4.20mm_Horizontal; Part number 0455580003
Q1: AO4421; SOIC-8_3.9x4.9mm_P1.27mm; Part number AO4421
R16, R18, R30, R31, R32, R33, R88: 10k; R_0603_1608Metric; Part number RC0603FR-0710KL
R17, R19, R20, R21, R22, R23, R24, R25, R26, R27, R34, R35: 1k; R_0603_1608Metric; Part number RC0603FR-071KL
R28, R29: 220; R_0603_1608Metric; Part number RC0603FR-07220RL
TP5, TP6, TP7: TestPoint; TestPoint_Pad_3.1x1.6mm; not fitted
U10, U11: 6N137; 6N137S_LTO; Part number 6N137S-TA1
U12, U13: EL3H7; SOP-4_4.4x2.6mm_P1.27mm; Part number EL3H7(B)(TA)-VG

Connections:
+3.3V: C36.1, C37.1, R28.2, R29.2, R34.1, R35.1, U10.8 (VCC), U11.8 (VCC); also elsewhere on the board
GND2: C36.2, C37.2, R88.1, U10.5 (GND), U11.5 (GND); also elsewhere on the board
unnamed: C34.1, D6.1 (K), R21.2, R25.1, R27.1
unnamed: C35.1, D7.1 (K), R23.2, R24.1, R26.1
unnamed: D8.2 (A), Q1.4 (G), R18.1, U12.4
unnamed: F1.2, J3.3
unnamed: F2.1, J3.4
unnamed: R17.2, R19.1
unnamed: R19.2, U13.3
unnamed: R20.2, R21.1
unnamed: R22.2, R23.1
unnamed: R28.1, U12.1
unnamed: R29.1, U13.1
unnamed: R30.2, R32.1
unnamed: R31.2, R33.1
unnamed: R25.2, R27.2, U10.2 (A)
unnamed: R24.2, R26.2, U11.2 (A)
unnamed: U12.3, U13.4
SAFE GND: C34.2, C35.2, D3.1 (A), D4.1 (A), D5.1 (A), D6.2 (A), D7.2 (A), F1.1, R16.1, R17.1, U10.3 (C), U11.3 (C)
STO CH1: R32.2, R34.2, TP6.1, U10.6 (VO), U12.2; also elsewhere on the board
STO CH1 FIELD: D5.3 (common), J3.1, R20.1
STO CH1 MCU FBK: R30.1; also elsewhere on the board
STO CH2: R33.2, R35.2, TP7.1, U11.6 (VO), U13.2; also elsewhere on the board
STO CH2 FIELD: D4.3 (common), J3.2, R22.1
STO CH2 MCU FBK: R31.1; also elsewhere on the board
STO EN: R88.2, TP5.1, U10.7 (EN), U11.7 (EN); also elsewhere on the board
STO FBK 24V: D8.1 (K), F2.2, Q1.1 (S), Q1.2 (S), Q1.3 (S), R18.2
STO FBK OUT: D3.3 (common), J3.5, Q1.5 (D), Q1.6 (D), Q1.7 (D), Q1.8 (D), R16.2

Notes on the sheet:
STO (Safe Torque Off)
STO ISOLATED AREA
