ExcessiveOverkill/drive-hardware-dev/KiCad/HV servo drive v1/HV servo drive v1.kicad_pcb

## KiCad design KiCad/HV servo drive v1/HV servo drive v1.kicad_pcb (continued)

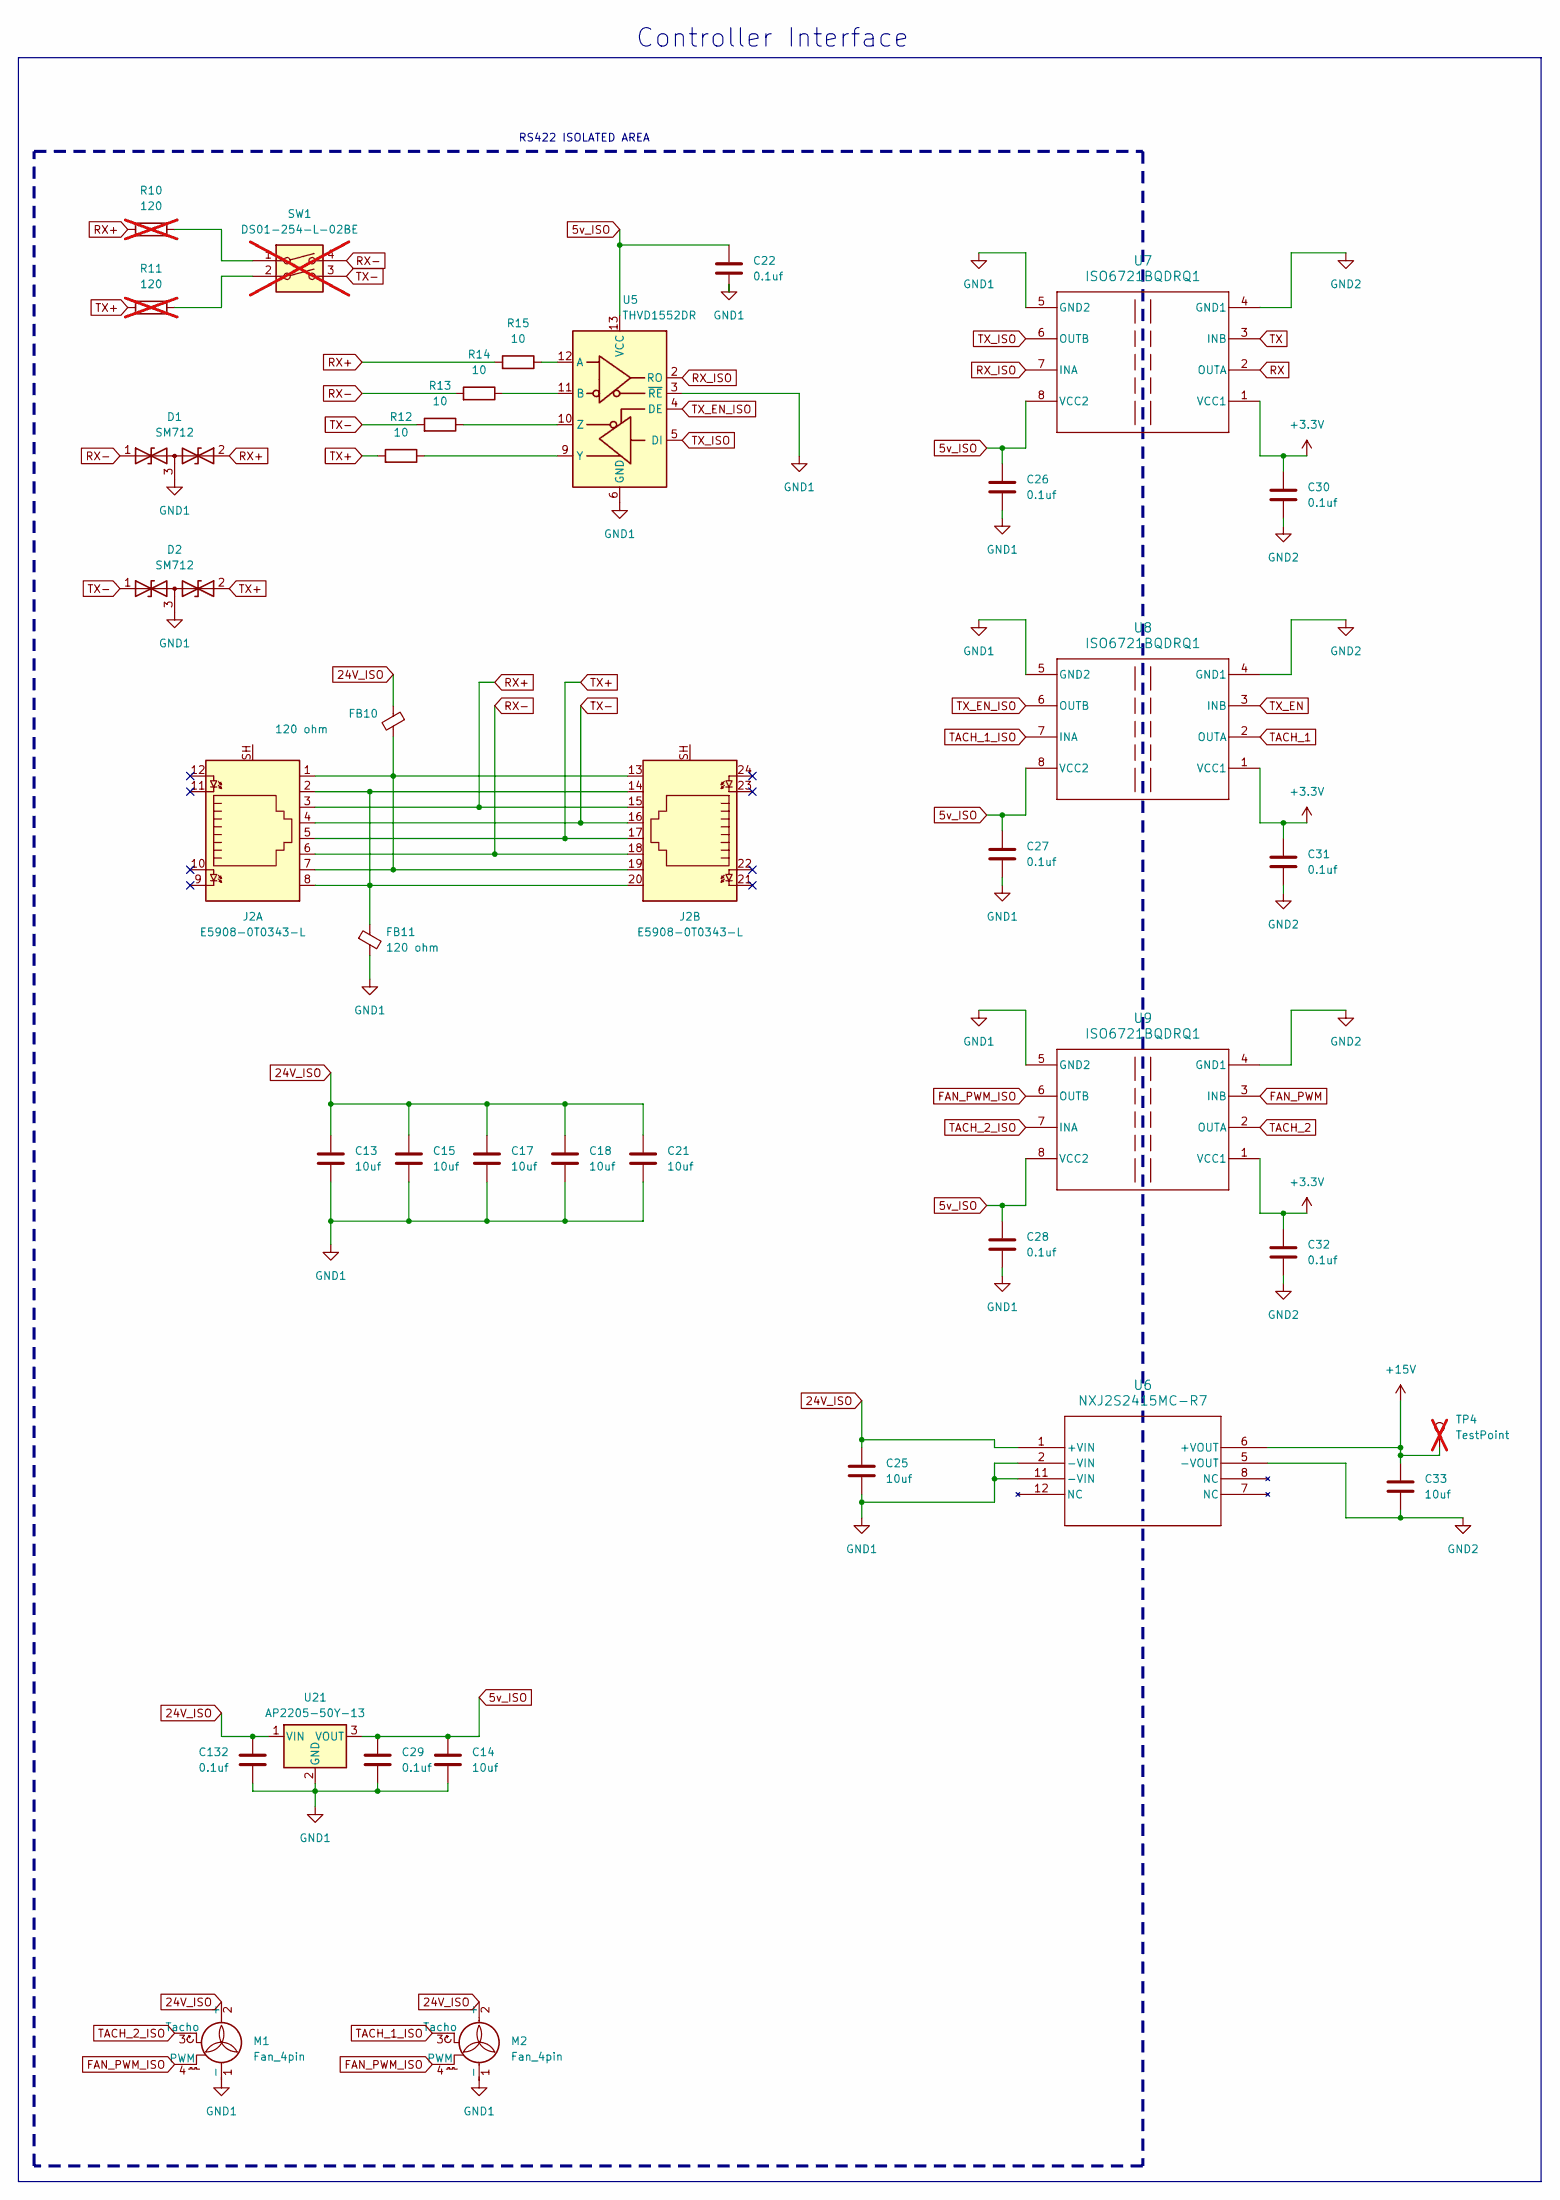
[picture p15: schematic controller interface.kicad_sch]

Parts:
C13, C14, C15, C17, C18, C21, C25, C33: 10uf; C_0805_2012Metric; Part number GRM21BR61H106KE43L
C22, C26, C27, C28, C29, C30, C31, C32, C132: 0.1uf; C_0603_1608Metric; Part number CC0603ZRY5V9BB104
D1, D2: SM712; SOT-23; Part number SM712
FB10, FB11: 120 ohm; L_0603_1608Metric; Part number LI0603G121R-10
J2: E5908-0T0343-L; RJ45_E5908-0T0343-L; Part number E5908-0T0343-L
M1, M2: Fan_4pin; Molex_SPOX_5267-04A_1x04_P2.50mm_Vertical; Part number 0022035045
R10, R11: 120; R_0603_1608Metric; Part number RC0603JR-07120RL; not fitted
R12, R13, R14, R15: 10; R_0603_1608Metric; Part number RMCF0603FT10R0
SW1: DS01-254-L-02BE; DIP-4_W7.62mm; Part number DS01-254-L-02BE; not fitted
TP4: TestPoint; TestPoint_Pad_3.1x1.6mm; not fitted
U5: THVD1552DR; SOIC-14_3.9x8.7mm_P1.27mm; Part number THVD1552DR
U6: NXJ2S2415MC-R7; NXJ2_24V_MUR; Part number NXJ2S2415MC-R7
U7, U8, U9: ISO6721BQDRQ1; SOICN-8_LTF; Part number ISO6721BQDRQ1
U21: AP2205-50Y-13; SOT-89-3; Part number AP2205-50Y-13

Connections:
5v_ISO: C14.1, C22.1, C26.1, C27.1, C28.1, C29.2, U5.13 (VCC), U5.14 (VCC), U7.8 (VCC2), U8.8 (VCC2), U9.8 (VCC2), U21.3 (VOUT)
24V_ISO: C13.1, C15.1, C17.1, C18.1, C21.1, C25.1, C132.1, FB10.1, M1.2 (+), M2.2 (+), U6.1 (+VIN), U21.1 (VIN)
+3.3V: C30.1, C31.1, C32.1, U7.1 (VCC1), U8.1 (VCC1), U9.1 (VCC1); also elsewhere on the board
+15V: C33.1, TP4.1, U6.6 (+VOUT); also elsewhere on the board
FAN_PWM: U9.3 (INB); also elsewhere on the board
FAN_PWM_ISO: M1.4 (PWM), M2.4 (PWM), U9.6 (OUTB)
GND1: C13.2, C14.2, C15.2, C17.2, C18.2, C21.2, C22.2, C25.2, C26.2, C27.2, C28.2, C29.1, C132.2, D1.3 (common), D2.3 (common), FB11.2, M1.1 (-), M2.1 (-), U5.3 (~RE), U5.6 (GND), U5.7 (GND), U6.2 (-VIN), U6.11 (-VIN), U7.5 (GND2), U8.5 (GND2), U9.5 (GND2), U21.2 (GND)
GND2: C30.2, C31.2, C32.2, C33.2, U6.5 (-VOUT), U7.4 (GND1), U8.4 (GND1), U9.4 (GND1); also elsewhere on the board
unnamed: FB10.2, J2.1, J2.7, J2.13, J2.19
unnamed: FB11.1, J2.2, J2.8, J2.14, J2.20
unnamed: R10.2, SW1.1
unnamed: R11.2, SW1.2
unnamed: R15.1, U5.12 (A)
unnamed: R14.1, U5.11 (B)
unnamed: R12.1, U5.9 (Y)
unnamed: R13.1, U5.10 (Z)
RX: U7.2 (OUTA); also elsewhere on the board
RX+: D1.2 (A2), J2.3, J2.15, R10.1, R15.2
RX-: D1.1 (A1), J2.6, J2.18, R14.2, SW1.4
RX_ISO: U5.2 (RO), U7.7 (INA)
TACH_1: U8.2 (OUTA); also elsewhere on the board
TACH_1_ISO: M2.3 (Tacho), U8.7 (INA)
TACH_2: U9.2 (OUTA); also elsewhere on the board
TACH_2_ISO: M1.3 (Tacho), U9.7 (INA)
TX: U7.3 (INB); also elsewhere on the board
TX+: D2.2 (A2), J2.5, J2.17, R11.1, R12.2
TX-: D2.1 (A1), J2.4, J2.16, R13.2, SW1.3
TX_EN: U8.3 (INB); also elsewhere on the board
TX_EN_ISO: U5.4 (DE), U8.6 (OUTB)
TX_ISO: U5.5 (DI), U7.6 (OUTB)

Notes on the sheet:
RS422 ISOLATED AREA
Controller Interface

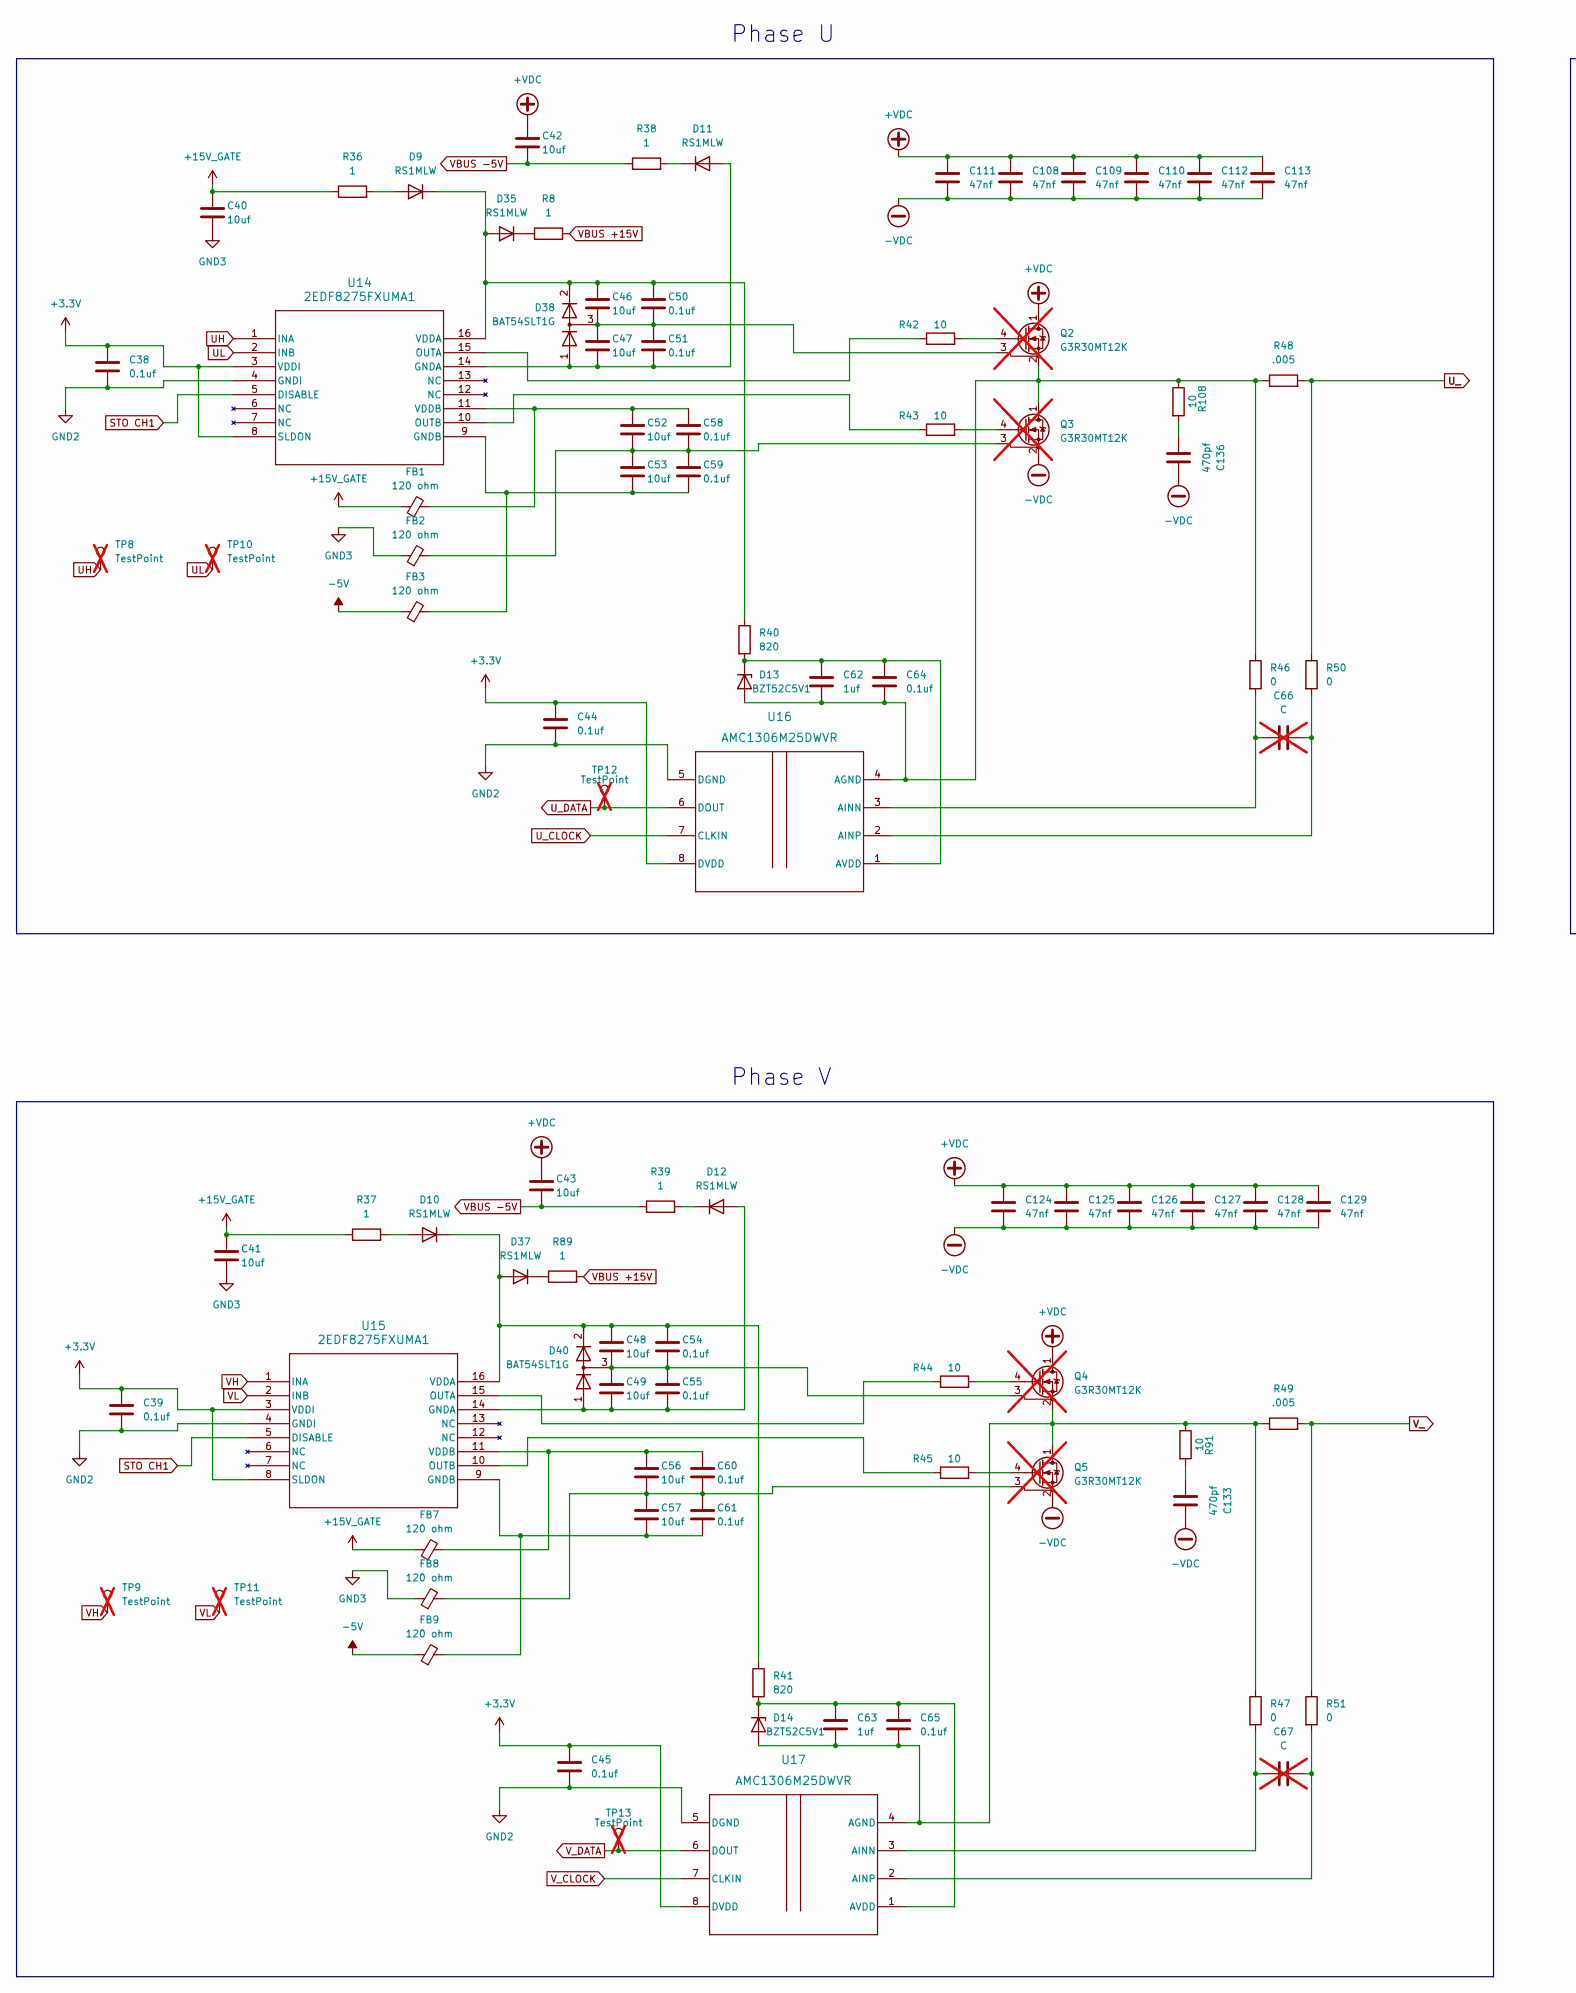
[picture p16: schematic phase bridges.kicad_sch, part in row 1, column 1]

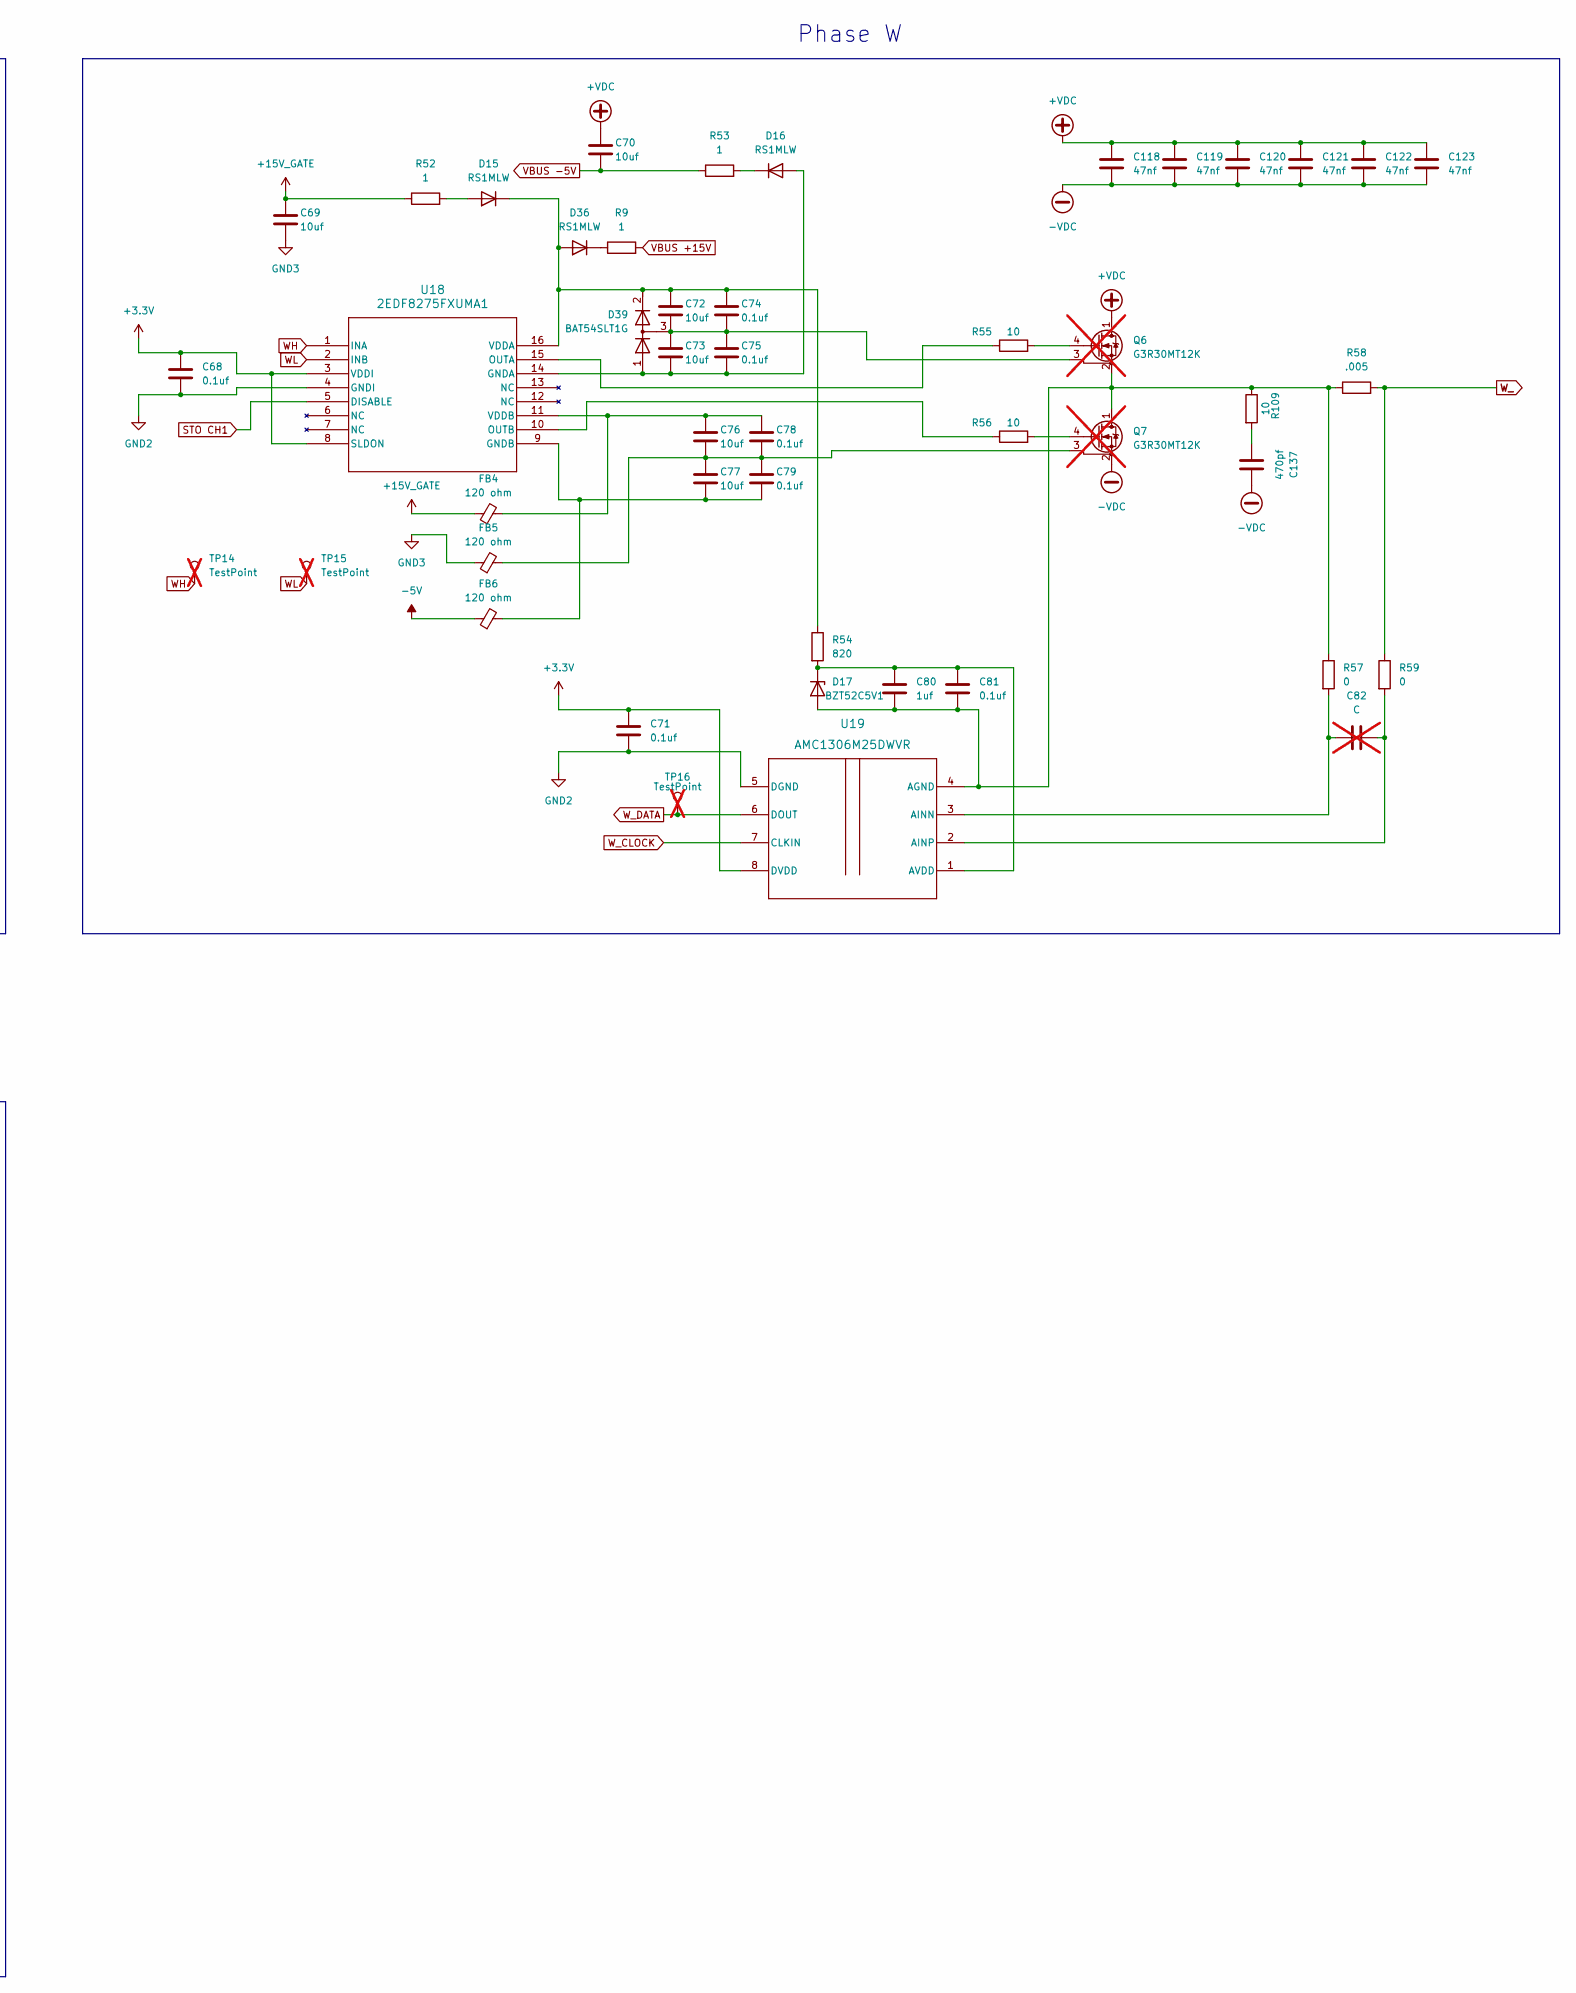
[picture p17: schematic phase bridges.kicad_sch, part in row 1, column 2]

Parts:
C38, C39, C44, C45, C50, C51, C54, C55, C58, C59, C60, C61, C64, C65, C68, C71, C74, C75, C78, C79, C81: 0.1uf; C_0603_1608Metric; Part number CC0603ZRY5V9BB104
C40, C41, C42, C43, C46, C47, C48, C49, C52, C53, C56, C57, C69, C70, C72, C73, C76, C77: 10uf; C_0805_2012Metric; Part number GRM21BR61H106KE43L
C62, C63, C80: 1uf; C_0603_1608Metric; Part number CL10A105KB8NNNC
C66, C67, C82: C; C_0603_1608Metric; not fitted
C108, C109, C110, C111, C112, C113, C118, C119, C120, C121, C122, C123, C124, C125, C126, C127, C128, C129: 47nf; C_1210_3225Metric; Part number C1210C473KDRACTU
C133, C136, C137: 470pf; C_1206_3216Metric; Part number GRM31A5C3A471FWA1D
D9, D10, D11, D12, D15, D16, D35, D36, D37: RS1MLW; D_SOD-123W; Part number RS1MLW
D13, D14, D17: BZT52C5V1; D_SOD-123; Part number BZT52C5V1-TP
D38, D39, D40: BAT54SLT1G; SOT-23; Part number BAT54SLT1G
FB1, FB2, FB3, FB4, FB5, FB6, FB7, FB8, FB9: 120 ohm; L_0603_1608Metric; Part number LI0603G121R-10
Q2, Q3, Q4, Q5, Q6, Q7: G3R30MT12K; TO-247-4_Horizontal_TabUp; Part number G3R30MT12K; not fitted
R8, R9, R36, R37, R38, R39, R52, R53, R89: 1; R_0805_2012Metric; Part number RC0805FR-131RL
R40, R41, R54: 820; R_0805_2012Metric; Part number RC0805JR-07820RL
R42, R43, R44, R45, R55, R56, R91, R108, R109: 10; R_1206_3216Metric; Part number RT1206FRE0710RL
R46, R47, R50, R51, R57, R59: 0; R_0603_1608Metric; Part number RC0603JR-070RL
R48, R49, R58: .005; RES_HCSM2818_STP; Part number HCSM2818FT5L00
TP8, TP9, TP10, TP11, TP12, TP13, TP14, TP15, TP16: TestPoint; TestPoint_Pad_3.1x1.6mm; not fitted
U14, U15, U18: 2EDF8275FXUMA1; PG-DSO-16-11; Part number 2EDF8275FXUMA1
U16, U17, U19: AMC1306M25DWVR; DWV0008A; Part number AMC1306M25DWVR

Connections:
+3.3V: C38.1, C39.1, C44.1, C45.1, C68.1, C71.1, U14.3 (VDDI), U14.8 (SLDON), U15.3 (VDDI), U15.8 (SLDON), U16.8 (DVDD), U17.8 (DVDD), U18.3 (VDDI), U18.8 (SLDON), U19.8 (DVDD); also elsewhere on the board
+15V_GATE: C40.1, C41.1, C69.1, FB1.1, FB4.1, FB7.1, R36.1, R37.1, R52.1; also elsewhere on the board
-5V: FB3.1, FB6.1, FB9.1; also elsewhere on the board
DCBUS+: C42.1, C43.1, C70.1, C108.1, C109.1, C110.1, C111.1, C112.1, C113.1, C118.1, C119.1, C120.1, C121.1, C122.1, C123.1, C124.1, C125.1, C126.1, C127.1, C128.1, C129.1, Q2.1 (D), Q4.1 (D), Q6.1 (D); also elsewhere on the board
DCBUS-: C108.2, C109.2, C110.2, C111.2, C112.2, C113.2, C118.2, C119.2, C120.2, C121.2, C122.2, C123.2, C124.2, C125.2, C126.2, C127.2, C128.2, C129.2, C133.2, C136.2, C137.2, Q3.2 (S), Q5.2 (S), Q7.2 (S); also elsewhere on the board
GND2: C38.2, C39.2, C44.2, C45.2, C68.2, C71.2, U14.4 (GNDI), U15.4 (GNDI), U16.5 (DGND), U17.5 (DGND), U18.4 (GNDI), U19.5 (DGND); also elsewhere on the board
GND3: C40.2, C41.2, C69.2, FB2.1, FB5.1, FB8.1; also elsewhere on the board
unnamed: C133.1, R91.2
unnamed: C136.1, R108.2
unnamed: C137.1, R109.2
unnamed: D9.2 (A), R36.2
unnamed: D10.2 (A), R37.2
unnamed: C48.1, C54.1, D10.1 (K), D37.2 (A), D40.2 (K), R41.1, U15.16 (VDDA)
unnamed: C47.2, C51.2, D11.2 (A), D38.1 (A), U14.14 (GNDA)
unnamed: D11.1 (K), R38.2
unnamed: C49.2, C55.2, D12.2 (A), D40.1 (A), U15.14 (GNDA)
unnamed: D12.1 (K), R39.2
unnamed: C62.2, C64.2, D13.2 (A), Q2.2 (S), Q3.1 (D), R46.1, R48.1, R108.1, U16.4 (AGND)
unnamed: C62.1, C64.1, D13.1 (K), R40.2, U16.1 (AVDD)
unnamed: C63.2, C65.2, D14.2 (A), Q4.2 (S), Q5.1 (D), R47.1, R49.1, R91.1, U17.4 (AGND)
unnamed: C63.1, C65.1, D14.1 (K), R41.2, U17.1 (AVDD)
unnamed: D15.2 (A), R52.2
unnamed: C72.1, C74.1, D15.1 (K), D36.2 (A), D39.2 (K), R54.1, U18.16 (VDDA)
unnamed: C73.2, C75.2, D16.2 (A), D39.1 (A), U18.14 (GNDA)
unnamed: D16.1 (K), R53.2
unnamed: C80.2, C81.2, D17.2 (A), Q6.2 (S), Q7.1 (D), R57.1, R58.1, R109.1, U19.4 (AGND)
unnamed: C80.1, C81.1, D17.1 (K), R54.2, U19.1 (AVDD)
unnamed: C46.1, C50.1, D9.1 (K), D35.2 (A), D38.2 (K), R40.1, U14.16 (VDDA)
unnamed: D35.1 (K), R8.1
unnamed: D36.1 (K), R9.1
unnamed: D37.1 (K), R89.1
unnamed: C46.2, C47.1, C50.2, C51.1, D38.3 (common), Q2.3 (DS)
unnamed: C72.2, C73.1, C74.2, C75.1, D39.3 (common), Q6.3 (DS)
unnamed: C48.2, C49.1, C54.2, C55.1, D40.3 (common), Q4.3 (DS)
unnamed: Q2.4 (G), R42.2
unnamed: C52.2, C53.1, C58.2, C59.1, FB2.2, Q3.3 (DS)
unnamed: Q3.4 (G), R43.2
unnamed: Q4.4 (G), R44.2
unnamed: C56.2, C57.1, C60.2, C61.1, FB8.2, Q5.3 (DS)
unnamed: Q5.4 (G), R45.2
unnamed: Q6.4 (G), R55.2
unnamed: C76.2, C77.1, C78.2, C79.1, FB5.2, Q7.3 (DS)
unnamed: Q7.4 (G), R56.2
unnamed: C53.2, C59.2, FB3.2, U14.9 (GNDB)
unnamed: R42.1, U14.15 (OUTA)
unnamed: R43.1, U14.10 (OUTB)
unnamed: C52.1, C58.1, FB1.2, U14.11 (VDDB)
unnamed: C57.2, C61.2, FB9.2, U15.9 (GNDB)
unnamed: R44.1, U15.15 (OUTA)
unnamed: R45.1, U15.10 (OUTB)
unnamed: C56.1, C60.1, FB7.2, U15.11 (VDDB)
unnamed: C66.1, R46.2, U16.3 (AINN)
unnamed: C66.2, R50.2, U16.2 (AINP)
unnamed: C67.1, R47.2, U17.3 (AINN)
unnamed: C67.2, R51.2, U17.2 (AINP)
unnamed: C77.2, C79.2, FB6.2, U18.9 (GNDB)
unnamed: R55.1, U18.15 (OUTA)
unnamed: R56.1, U18.10 (OUTB)
unnamed: C76.1, C78.1, FB4.2, U18.11 (VDDB)
unnamed: C82.1, R57.2, U19.3 (AINN)
unnamed: C82.2, R59.2, U19.2 (AINP)
STO CH1: U14.5 (DISABLE), U15.5 (DISABLE), U18.5 (DISABLE); also elsewhere on the board
UH: TP8.1, U14.1 (INA); also elsewhere on the board
UL: TP10.1, U14.2 (INB); also elsewhere on the board
U_: R48.2, R50.1; also elsewhere on the board
U_CLOCK: U16.7 (CLKIN); also elsewhere on the board
U_DATA: TP12.1, U16.6 (DOUT); also elsewhere on the board
VBUS +15V: R8.2, R9.2, R89.2; also elsewhere on the board
VBUS -5V: C42.2, C43.2, C70.2, R38.1, R39.1, R53.1; also elsewhere on the board
VH: TP9.1, U15.1 (INA); also elsewhere on the board
VL: TP11.1, U15.2 (INB); also elsewhere on the board
V_: R49.2, R51.1; also elsewhere on the board
V_CLOCK: U17.7 (CLKIN); also elsewhere on the board
V_DATA: TP13.1, U17.6 (DOUT); also elsewhere on the board
WH: TP14.1, U18.1 (INA); also elsewhere on the board
WL: TP15.1, U18.2 (INB); also elsewhere on the board
W_: R58.2, R59.1; also elsewhere on the board
W_CLOCK: U19.7 (CLKIN); also elsewhere on the board
W_DATA: TP16.1, U19.6 (DOUT); also elsewhere on the board

Notes on the sheet:
Phase V
Phase W
Phase U

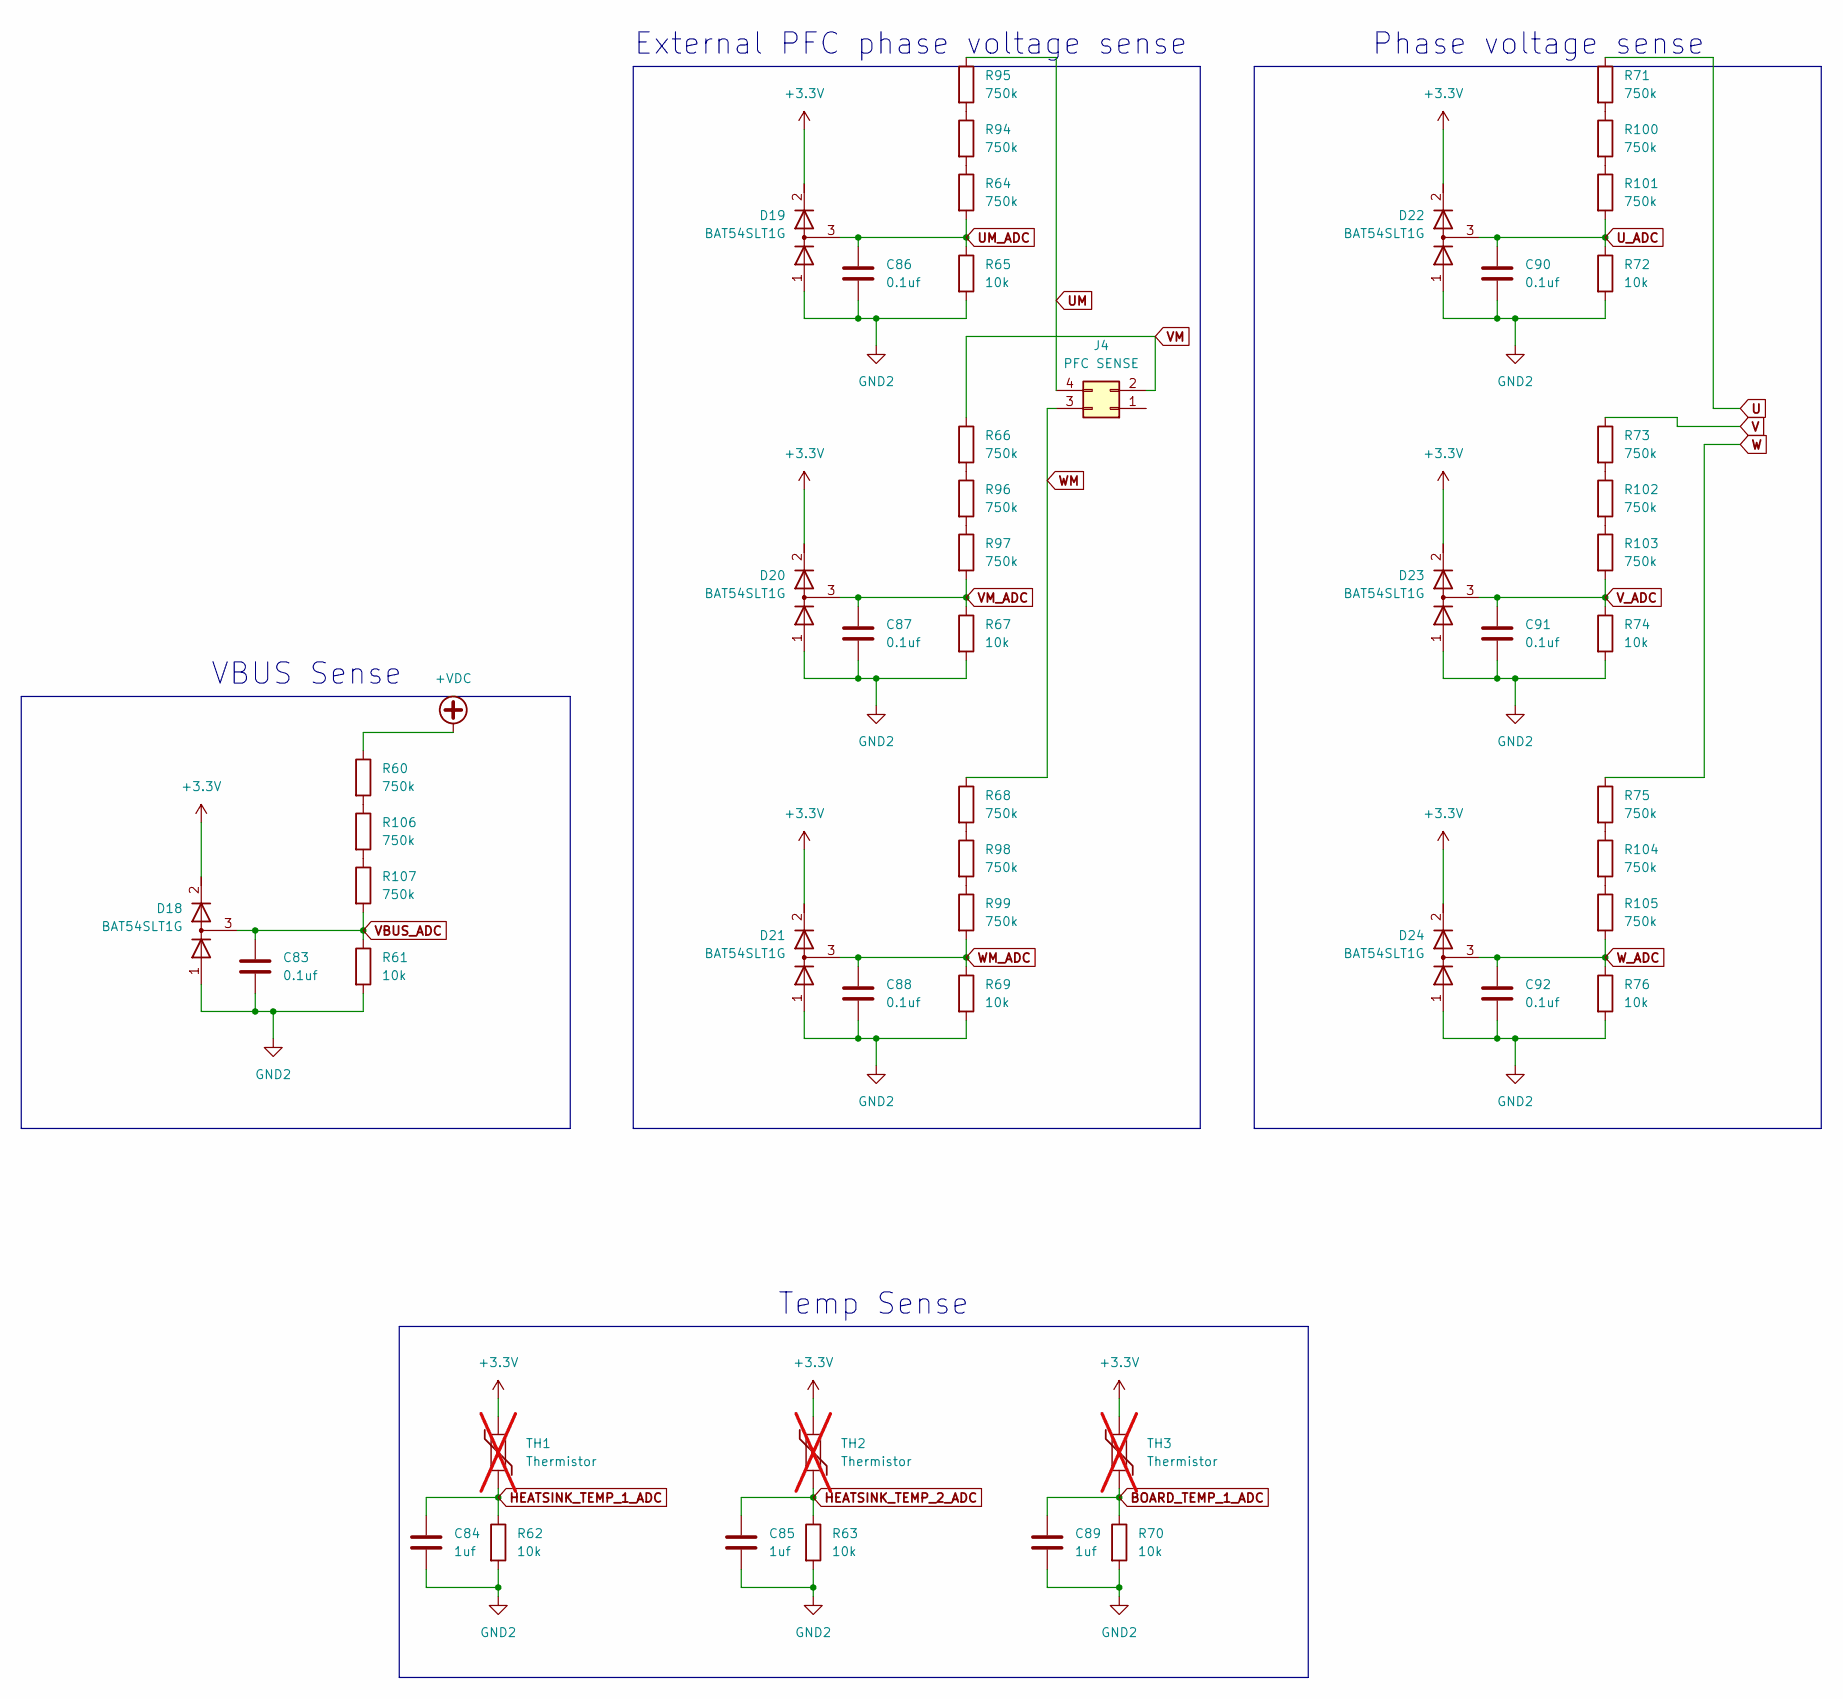
[picture p18: schematic adc sense.kicad_sch]

Parts:
C83, C86, C87, C88, C90, C91, C92: 0.1uf; C_0603_1608Metric; Part number CC0603ZRY5V9BB104
C84, C85, C89: 1uf; C_0603_1608Metric; Part number CL10A105KB8NNNC
D18, D19, D20, D21, D22, D23, D24: BAT54SLT1G; SOT-23; Part number BAT54SLT1G
J4: PFC SENSE; Molex_Mini-Fit_Jr_5569-04A2_2x02_P4.20mm_Horizontal; Part number 0469990014
R60, R64, R66, R68, R71, R73, R75, R94, R95, R96, R97, R98, R99, R100, R101, R102, R103, R104, R105, R106, R107: 750k; R_1206_3216Metric; Part number RC1206FR-07750KL
R61, R62, R63, R65, R67, R69, R70, R72, R74, R76: 10k; R_0603_1608Metric; Part number RC0603FR-0710KL
TH1, TH2: Thermistor; PinHeader_1x02_P2.54mm_Vertical; not fitted
TH3: Thermistor; R_0603_1608Metric; not fitted

Connections:
+3.3V: D18.2 (K), D19.2 (K), D20.2 (K), D21.2 (K), D22.2 (K), D23.2 (K), D24.2 (K), TH1.1, TH2.1, TH3.1; also elsewhere on the board
BOARD_TEMP_1_ADC: C89.1, R70.1, TH3.2; also elsewhere on the board
DCBUS+: R60.1; also elsewhere on the board
GND2: C83.2, C84.2, C85.2, C86.2, C87.2, C88.2, C89.2, C90.2, C91.2, C92.2, D18.1 (A), D19.1 (A), D20.1 (A), D21.1 (A), D22.1 (A), D23.1 (A), D24.1 (A), R61.2, R62.2, R63.2, R65.2, R67.2, R69.2, R70.2, R72.2, R74.2, R76.2; also elsewhere on the board
HEATSINK_TEMP_1_ADC: C84.1, R62.1, TH1.2; also elsewhere on the board
HEATSINK_TEMP_2_ADC: C85.1, R63.1, TH2.2; also elsewhere on the board
unnamed: R64.1, R94.2
unnamed: R66.2, R96.1
unnamed: R68.2, R98.1
unnamed: R94.1, R95.2
unnamed: R96.2, R97.1
unnamed: R98.2, R99.1
unnamed: R71.2, R100.1
unnamed: R100.2, R101.1
unnamed: R73.2, R102.1
unnamed: R102.2, R103.1
unnamed: R75.2, R104.1
unnamed: R104.2, R105.1
unnamed: R60.2, R106.1
unnamed: R106.2, R107.1
U: R71.1; also elsewhere on the board
UM: J4.4, R95.1
UM_ADC: C86.1, D19.3 (common), R64.2, R65.1; also elsewhere on the board
U_ADC: C90.1, D22.3 (common), R72.1, R101.2; also elsewhere on the board
V: R73.1; also elsewhere on the board
VBUS_ADC: C83.1, D18.3 (common), R61.1, R107.2; also elsewhere on the board
VM: J4.2, R66.1
VM_ADC: C87.1, D20.3 (common), R67.1, R97.2; also elsewhere on the board
V_ADC: C91.1, D23.3 (common), R74.1, R103.2; also elsewhere on the board
W: R75.1; also elsewhere on the board
WM: J4.3, R68.1
WM_ADC: C88.1, D21.3 (common), R69.1, R99.2; also elsewhere on the board
W_ADC: C92.1, D24.3 (common), R76.1, R105.2; also elsewhere on the board

Notes on the sheet:
VBUS Sense
External PFC phase voltage sense
Phase voltage sense
Temp Sense

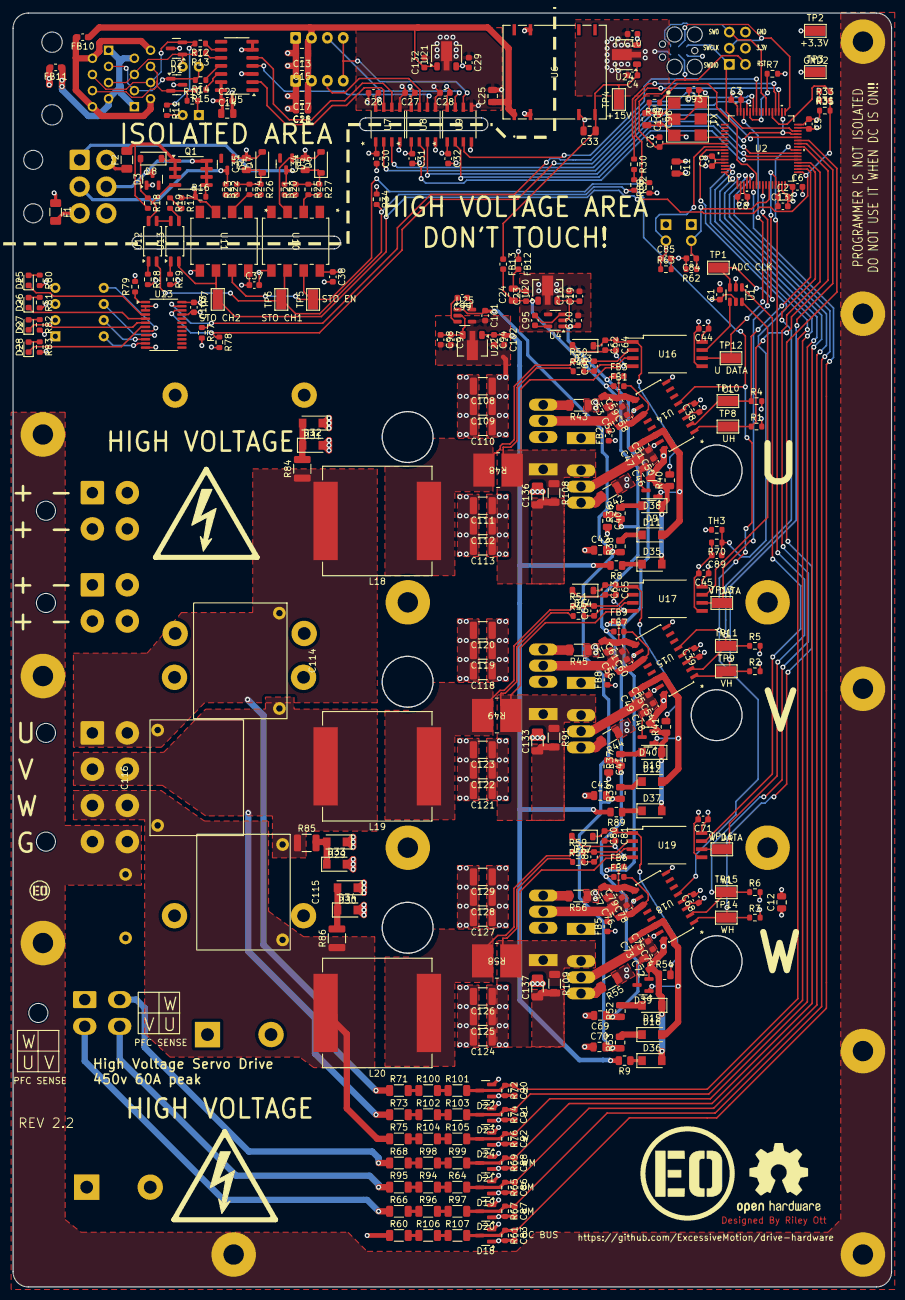
[picture p19: board HV servo drive v1.kicad_pcb from above]

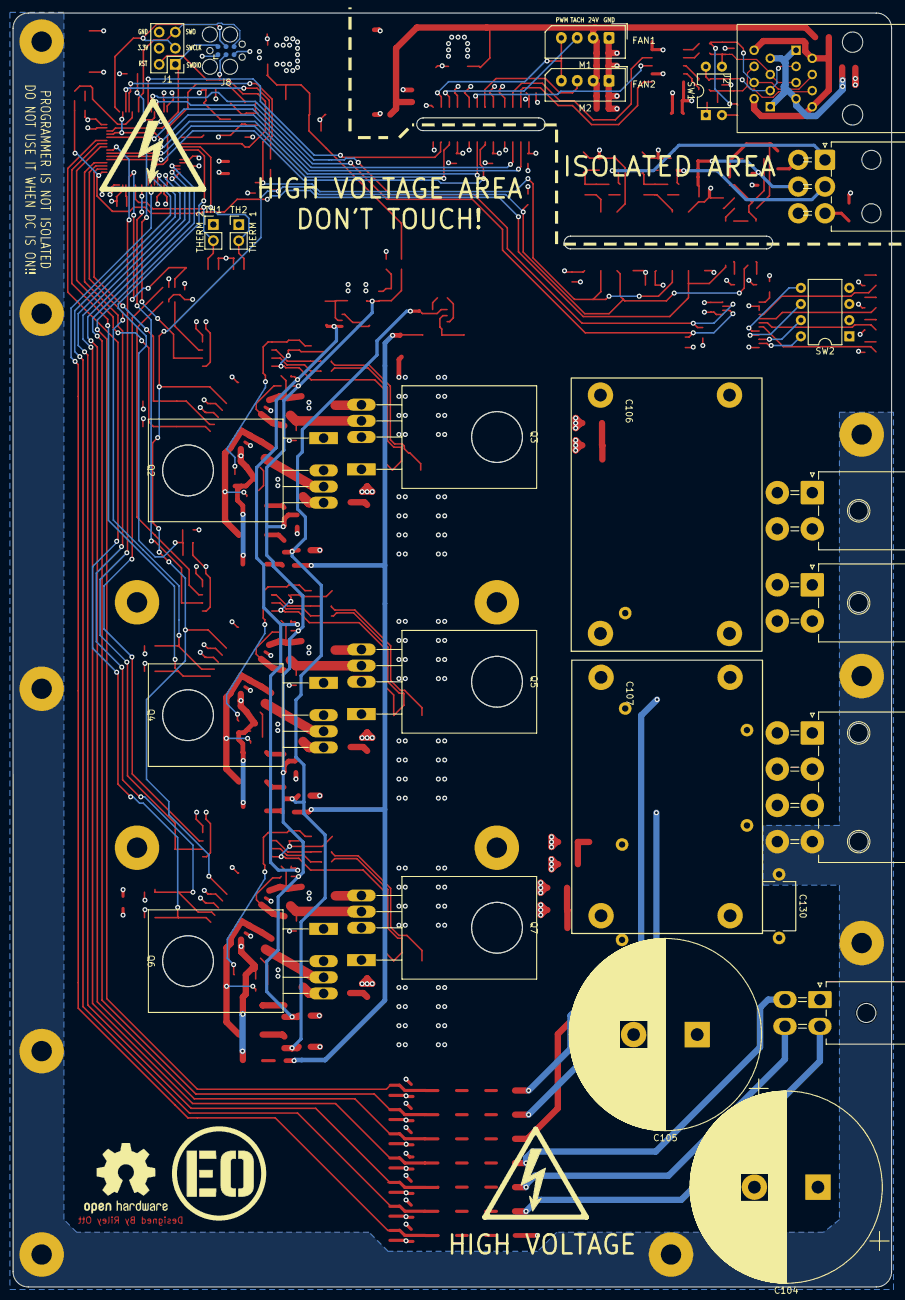
[picture p20: board HV servo drive v1.kicad_pcb from below]

Board: 4 copper layers, 138.2 x 200.4 mm, 374 parts (25 on the bottom side), 197 nets.
