ExcessiveOverkill/drive-hardware-dev/KiCad/Current Sensor/Current Sensor.kicad_pcb

## KiCad design KiCad/Current Sensor/Current Sensor.kicad_pcb (2024-04-11)

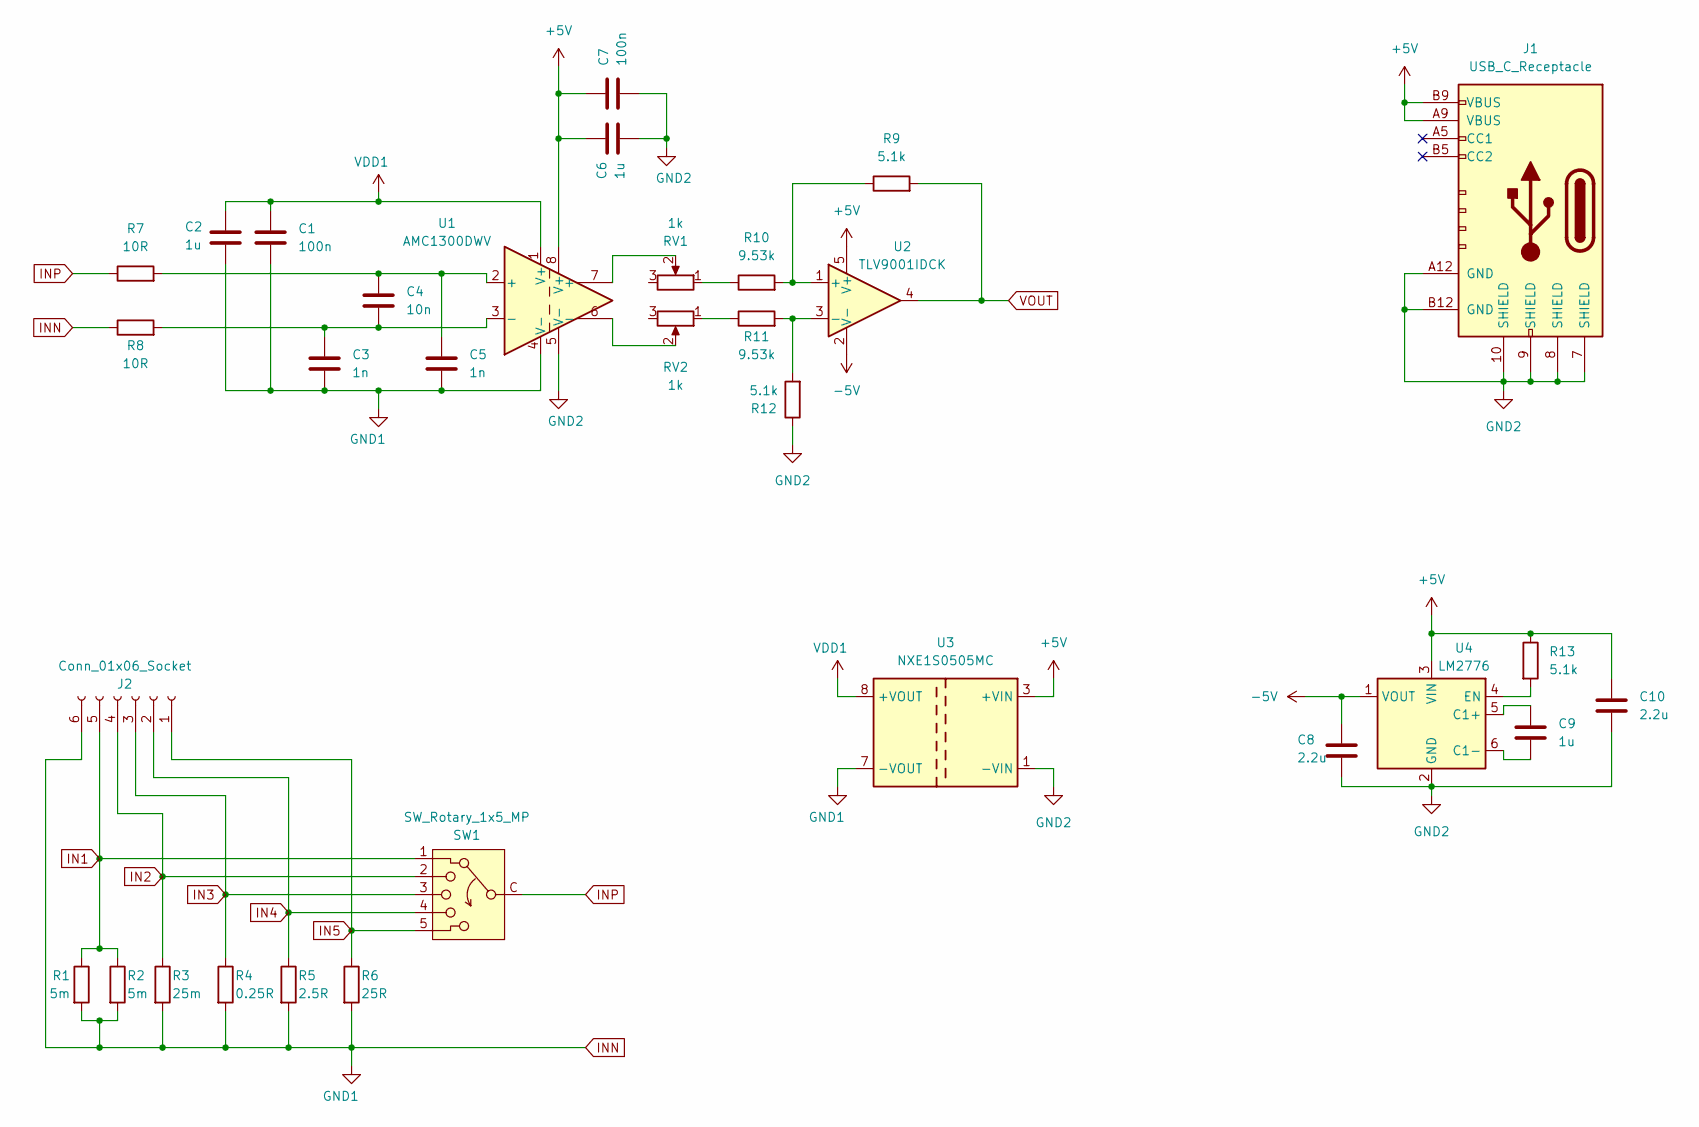
[picture p21: schematic Current Sensor.kicad_sch]

Parts:
C1, C7: 100n; C_0603_1608Metric
C2, C6, C9: 1u; C_0603_1608Metric
C3, C5: 1n; C_0603_1608Metric
C4: 10n; C_0603_1608Metric
C8, C10: 2.2u; C_0603_1608Metric
J1: USB_C_Receptacle; CONN_10164359-00011LF_AMP
J2: Conn_01x06_Socket; CONN_1017495
R1, R2: 5m; R_2816_7142Metric
R3: 25m; R_2816_7142Metric
R4: 0.25R; R_2816_7142Metric
R5: 2.5R; R_0603_1608Metric
R6: 25R; R_0603_1608Metric
R7, R8: 10R; R_0603_1608Metric
R9, R12, R13: 5.1k; R_0603_1608Metric
R10, R11: 9.53k; R_0603_1608Metric
RV1, RV2: 1k; Potentiometer_Bourns_3296W_Vertical
SW1: SW_Rotary_1x5_MP; RotarySwitch_C&J_RM
U1: AMC1300DWV; SOIC-8_7.5x5.85mm_P1.27mm
U2: TLV9001IDCK; SOT-353_SC-70-5
U3: NXE1S0505MC; Converter_DCDC_Murata_NXExSxxxxMC_SMD
U4: LM2776; SOT-23-6

Connections:
+5V: C6.1, C7.1, C10.1, J1.A9 (VBUS), J1.B9 (VBUS), R13.1, U1.8 (V+), U2.5 (V+), U3.3 (+VIN), U4.3 (VIN); also elsewhere on the board
-5V: C8.1, U2.2 (V-), U4.1 (VOUT)
GND2: C6.2, C7.2, C8.2, C10.2, J1.7 (SHIELD), J1.8 (SHIELD), J1.9 (SHIELD), J1.10 (SHIELD), J1.A12 (GND), J1.B12 (GND), R12.1, U1.5 (V-), U3.1 (-VIN), U4.2 (GND); also elsewhere on the board
IN1: J2.5, R1.1, R2.1, SW1.1
IN2: J2.4, R3.1, SW1.2
IN3: J2.3, R4.1, SW1.3
IN4: J2.2, R5.1, SW1.4
IN5: J2.1, R6.1, SW1.5
INN: C1.2, C2.2, C3.2, C5.2, J2.6, R1.2, R2.2, R3.2, R4.2, R5.2, R6.2, R8.1, U1.4 (V-), U3.7 (-VOUT)
INP: R7.1, SW1.C
unnamed: C3.1, C4.2, R8.2, U1.3 (-)
unnamed: C4.1, C5.1, R7.2, U1.2 (+)
unnamed: R10.1, RV1.1
unnamed: R11.1, RV2.1
unnamed: RV1.2, U1.7 (+)
unnamed: RV2.2, U1.6 (-)
unnamed: R9.1, R10.2, U2.1 (+)
unnamed: R11.2, R12.2, U2.3 (-)
unnamed: C9.1, U4.5 (C1+)
unnamed: C9.2, U4.6 (C1-)
unnamed: R13.2, U4.4 (EN)
VDD1: C1.1, C2.1, U1.1 (V+), U3.8 (+VOUT)
VOUT: R9.2, U2.4; also elsewhere on the board

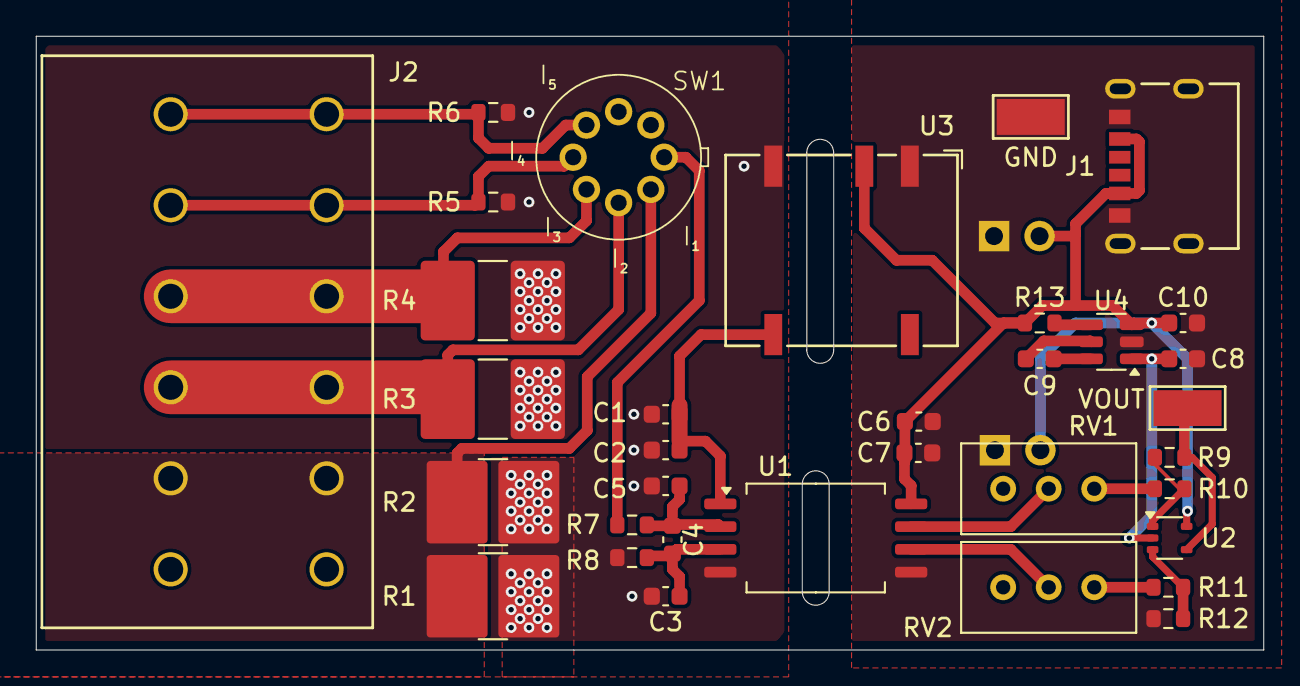
[picture p22: board Current Sensor.kicad_pcb from above]

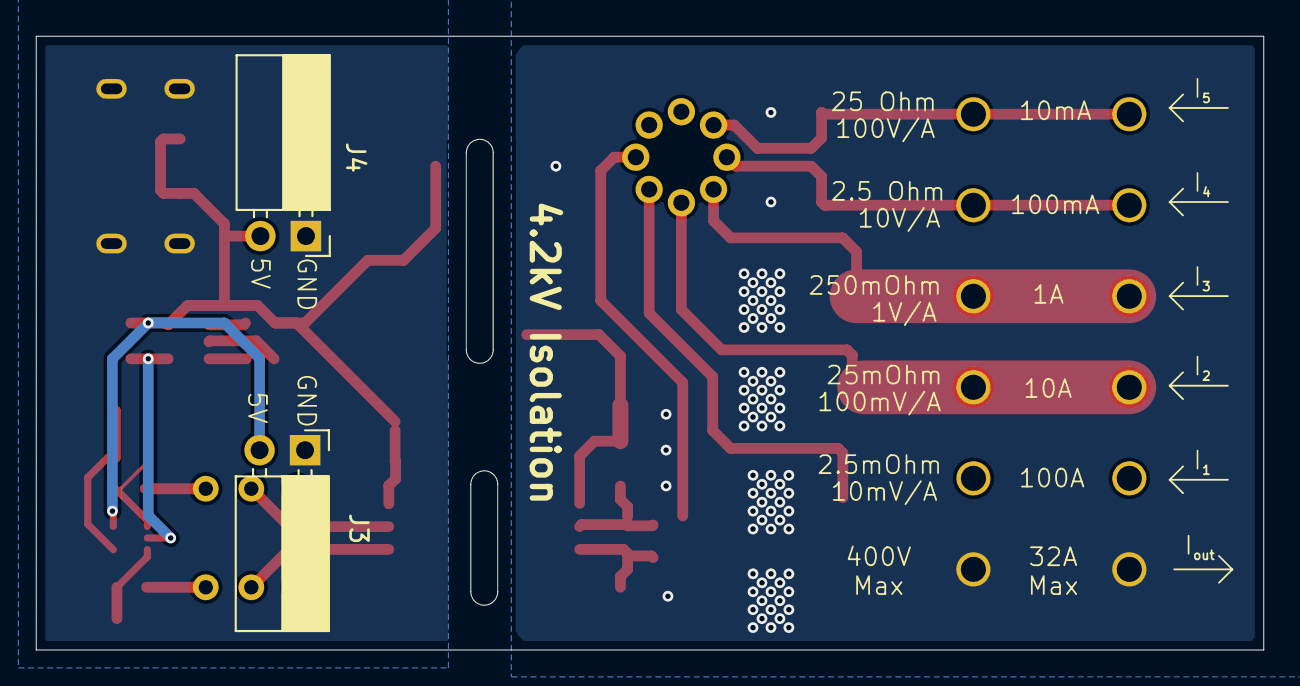
[picture p23: board Current Sensor.kicad_pcb from below]

Board: 2 copper layers, 68.5 x 34.2 mm, 36 parts (2 on the bottom side), 23 nets.

Other parts of the board:
GND: TestPoint_Keystone_5019_Minature
J3, J4: PinSocket_1x02_P2.54mm_Horizontal
VOUT: TestPoint_Keystone_5019_Minature

Their connections:
+5V: J3.2, J4.2; also elsewhere on the board
GND2: GND.1, J3.1, J4.1; also elsewhere on the board
VOUT: VOUT.1; also elsewhere on the board
