ExcessiveOverkill/drive-hardware-dev/(commit log)

2024-03-11 KiCad 8.0 update
    [HV servo drive v1.kicad_pcb, HV servo drive v1.kicad_sch, adc sense.kicad_sch, controller interface.kicad_sch, gate supplies.kicad_sch, mcu.kicad_sch, mounting.kicad_sch, phase bridges.kicad_sch]
2024-04-11 Added current sensor KiCad project
    [Current Sensor.kicad_pcb, Current Sensor.kicad_sch]
2024-04-19 start rev 2 changes
    fix component references, fix rj45 and dc-dc converter footprints, add RLC filters on all power connectors, add more mounting holes
    [HV servo drive v1.kicad_pcb, HV servo drive v1.kicad_sch, adc sense.kicad_sch, controller interface.kicad_sch, gate supplies.kicad_sch, mcu.kicad_sch, mounting.kicad_sch, phase bridges.kicad_sch]
2024-04-23 add STO enable pulldown for MCU
    [sto.kicad_sch]
2024-04-26 round PCb edges
    [HV servo drive v1.kicad_pcb, controller interface.kicad_sch]
2025-04-02 add heatsink files
    [HV servo drive v1_PCB.ipt, heatsink v2.ipt]
2025-09-05 update to rev 2.1
    basically the same version as in the FOC youtube video, with some minor issues fixed
    [95185A110_Zinc-Plated Steel Press-Fit Nut for Sheet Metal.ipt, 95185A340_Zinc-Plated Steel Press-Fit Nut for Sheet Metal.ipt, CP_Radial_D30.0mm_P10.00mm_SnapIn.iam, CP_Radial_D300mm_P1000mm_SnapIn.ipt, CQ assembly.ipt, C_0603_1608Metric.iam, C_0603_1608Metric.ipt, C_0805_2012Metric.iam]
2025-09-05 add reverse protection diodes to gate supply
    [HV servo drive v1-B_Cu.gbr, HV servo drive v1-B_Mask.gbr, HV servo drive v1-B_Paste.gbr, HV servo drive v1-B_Silkscreen.gbr, HV servo drive v1-Edge_Cuts.gbr, HV servo drive v1-F_Cu.gbr, HV servo drive v1-F_Mask.gbr, HV servo drive v1-F_Paste.gbr]
